ss1-ops/robotic-arm-5-digit-manipulator/gripper/aero-hand-open/hardware/README.md

**License:** [CC BY-NC-SA 4.0](https://creativecommons.org/licenses/by-nc-sa/4.0/) © 2025 TetherIA

[**Mechanical**](https://docs.tetheria.ai/docs/mechanical)

[**Assembly**](https://docs.tetheria.ai/docs/assembly)

[**Hardware Setup**](https://docs.tetheria.ai/docs/hardware_setup)

[**PCB**](https://docs.tetheria.ai/docs/pcb)

[**Firmware**](https://docs.tetheria.ai/docs/firmware)
