ss1-ops/robotic-arm-5-digit-manipulator/software/vision/ChArUCo Board.pdf

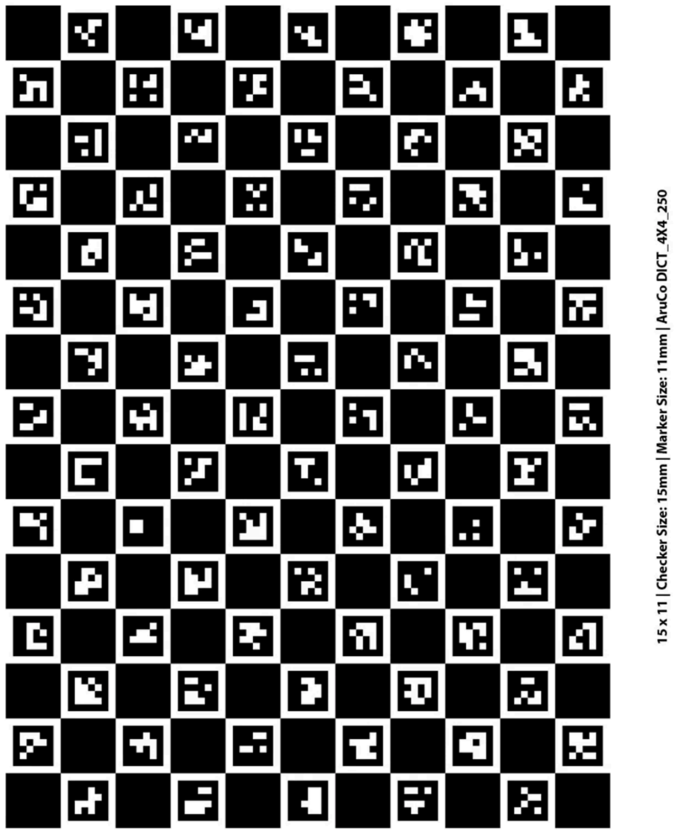
[picture p16: page 1]
