ss1-ops/robotic-arm-5-digit-manipulator/software/vision/charuco_7x5.pdf

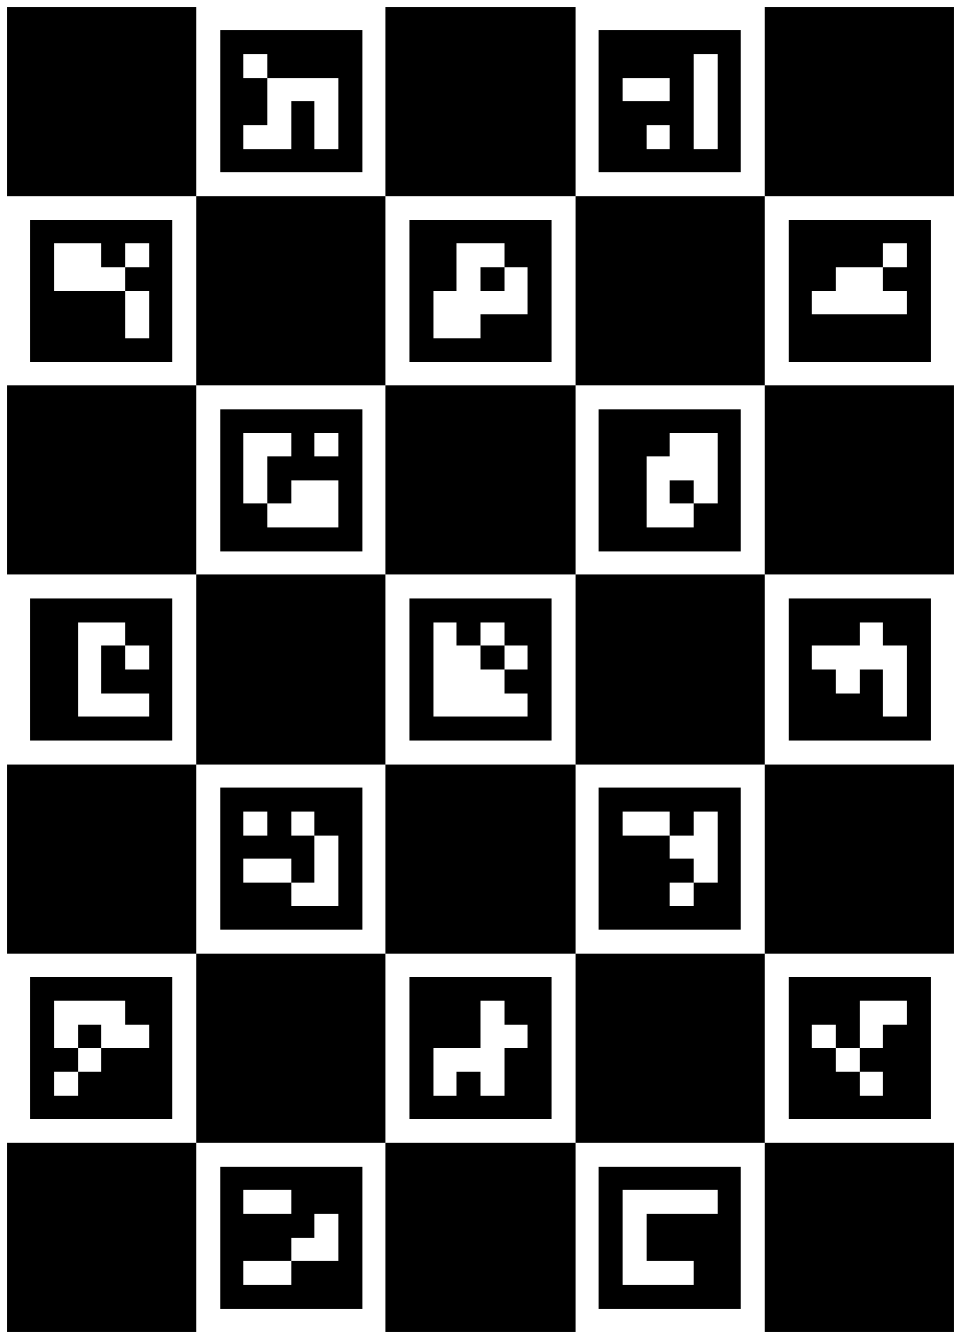
[picture p17: page 1]
