ss1-ops/robotic-arm-5-digit-manipulator/gripper/aero-hand-open/hardware/CAD/mount_adapters/assets/135degrees_adapter.png

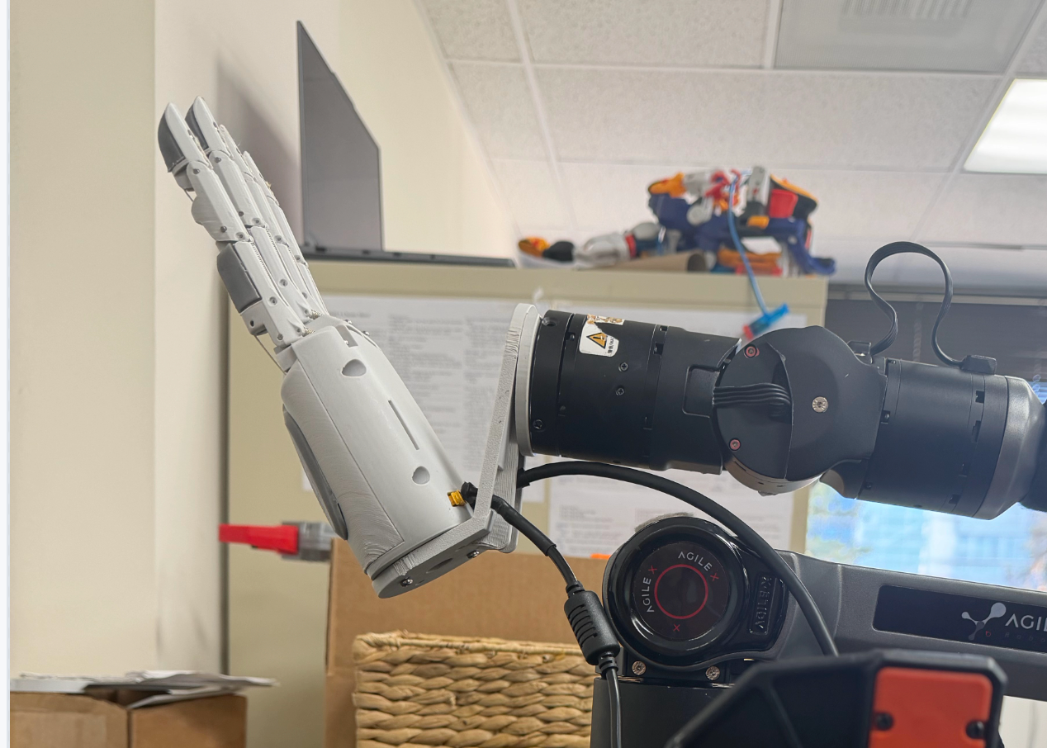
gripper/aero-hand-open/hardware/CAD/mount_adapters/assets/135degrees_adapter.png
