ss1-ops/robotic-arm-5-digit-manipulator/gripper/aero-hand-open/hardware/CAD/Molds/Proximal_Pad_Mold.stp

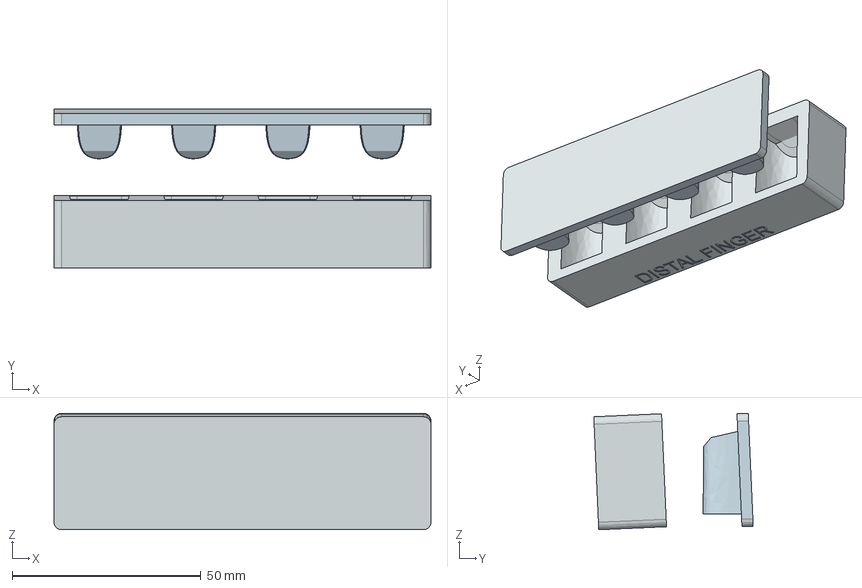
[picture p19: CAD file, 2026-04-10]
gripper/aero-hand-open/hardware/CAD/Molds/Proximal_Pad_Mold.stp
100.0 x 42.3 x 30.9 mm
