ss1-ops/robotic-arm-5-digit-manipulator/gripper/aero-hand-open/hardware/PCB/Components/100uF cap/100ufcap.stp

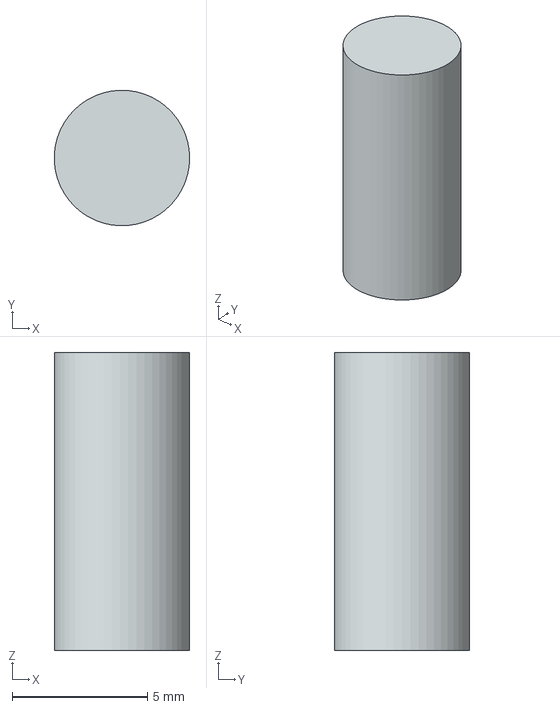
[picture p20: CAD file, 2026-04-10]
gripper/aero-hand-open/hardware/PCB/Components/100uF cap/100ufcap.stp
5.00 x 5.00 x 11.0 mm
