ss1-ops/robotic-arm-5-digit-manipulator/gripper/aero-hand-open/hardware/PCB/Components/ESP32s3/XIAO ESP32S3 3D.stp

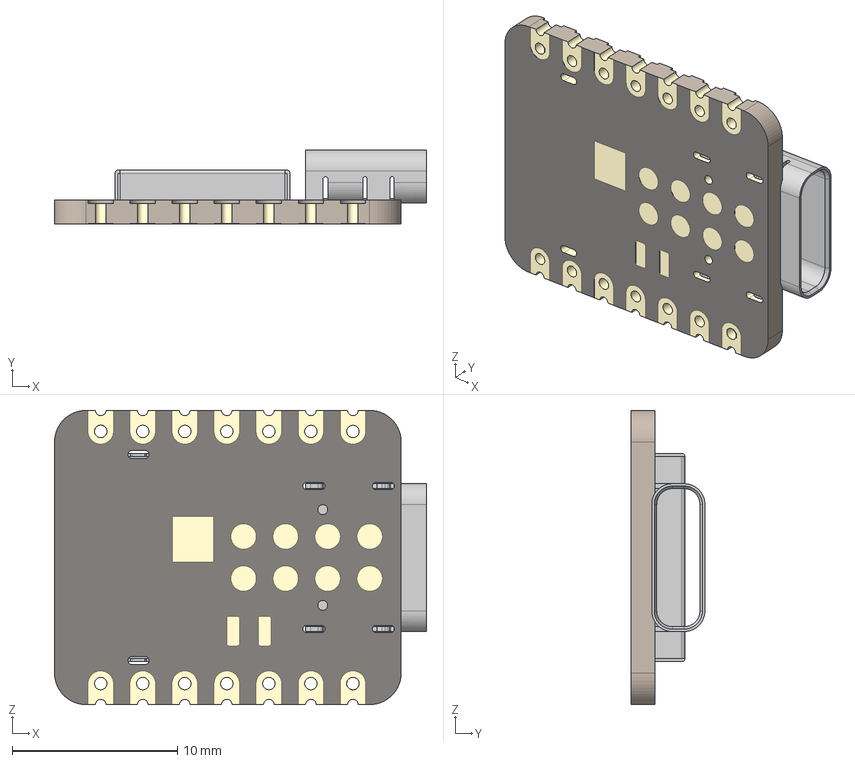
[picture p21: CAD file, 2026-04-10]
gripper/aero-hand-open/hardware/PCB/Components/ESP32s3/XIAO ESP32S3 3D.stp
22.5 x 4.46 x 17.8 mm
