ss1-ops/robotic-arm-5-digit-manipulator/gripper/aero-hand-open/hardware/PCB/Components/XT30PW-M/3D/XT30PW-M.stp

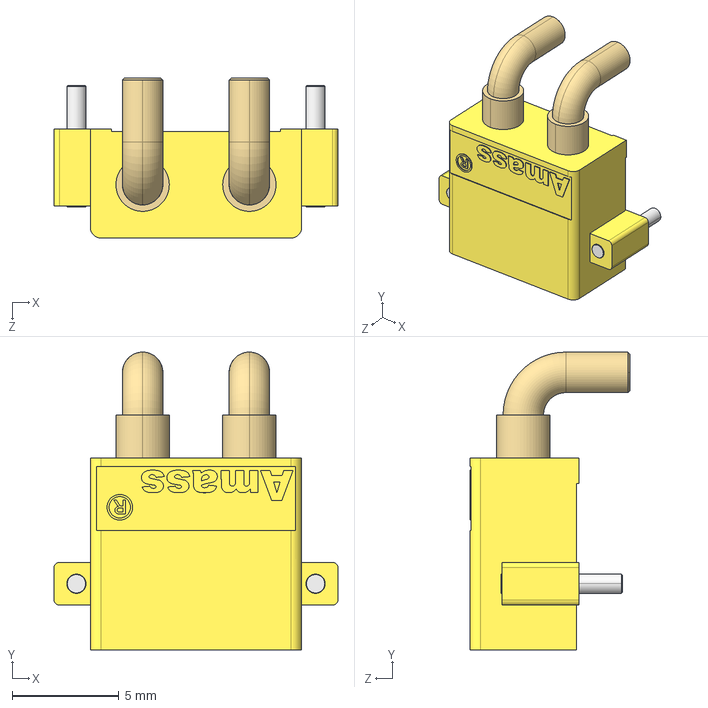
[picture p22: CAD file, 2026-04-10]
gripper/aero-hand-open/hardware/PCB/Components/XT30PW-M/3D/XT30PW-M.stp
13.3 x 13.9 x 7.50 mm
