ss1-ops/robotic-arm-5-digit-manipulator/gripper/aero-hand-open/hardware/CAD/Molds/Finger_Distal_Mold.stp

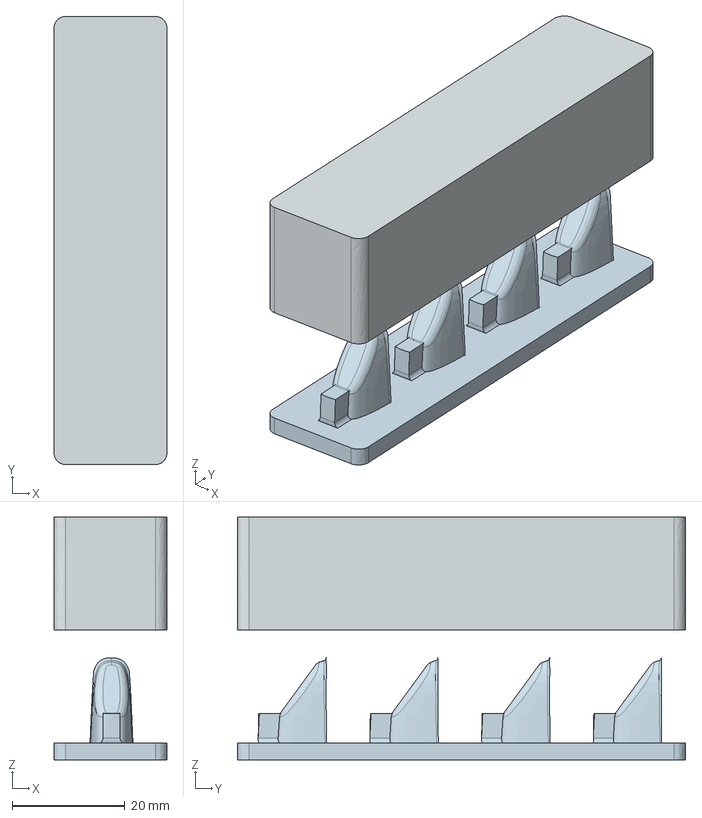
[picture p23: CAD file, 2026-04-10]
gripper/aero-hand-open/hardware/CAD/Molds/Finger_Distal_Mold.stp
20.0 x 79.4 x 43.0 mm
