ss1-ops/robotic-arm-5-digit-manipulator/gripper/aero-hand-open/hardware/CAD/Molds/Palm_Silicone_Mold_R.stp

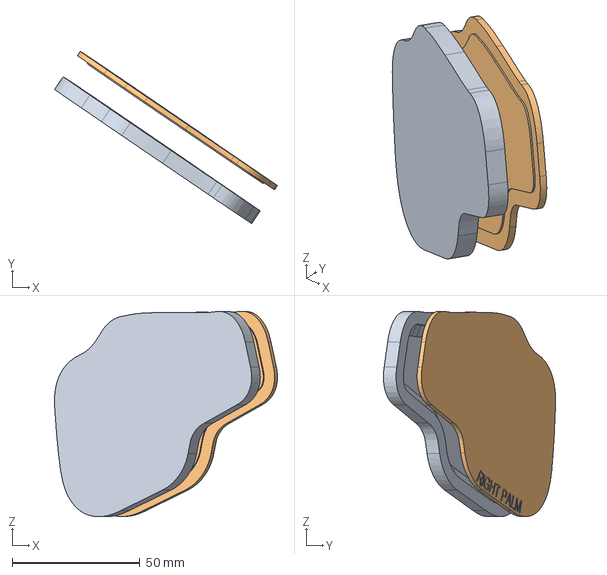
[picture p24: CAD file, 2026-04-10]
gripper/aero-hand-open/hardware/CAD/Molds/Palm_Silicone_Mold_R.stp
87.5 x 67.5 x 80.6 mm
