ss1-ops/robotic-arm-5-digit-manipulator/gripper/aero-hand-open/hardware/CAD/mount_adapters/G1_Open_Unitree_Converter.stp

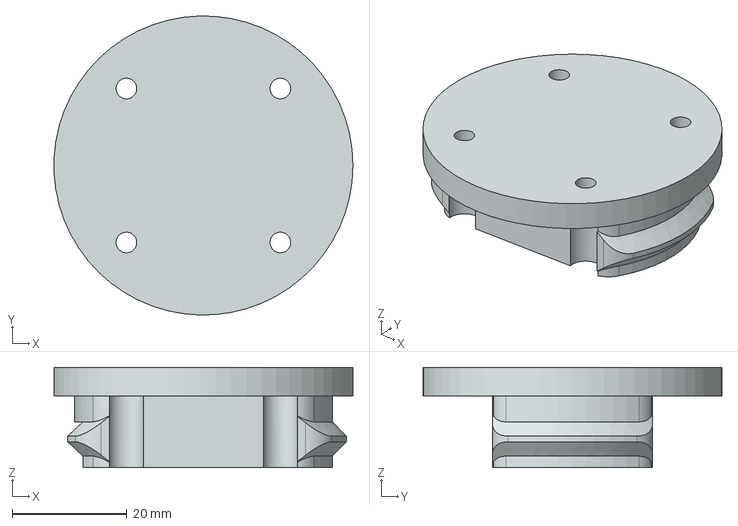
[picture p25: CAD file, 2026-04-10]
gripper/aero-hand-open/hardware/CAD/mount_adapters/G1_Open_Unitree_Converter.stp
52.2 x 52.2 x 17.5 mm
