ss1-ops/robotic-arm-5-digit-manipulator/gripper/aero-hand-open/hardware/CAD/Molds/Thumb_Distal_Pad_Mold.stp

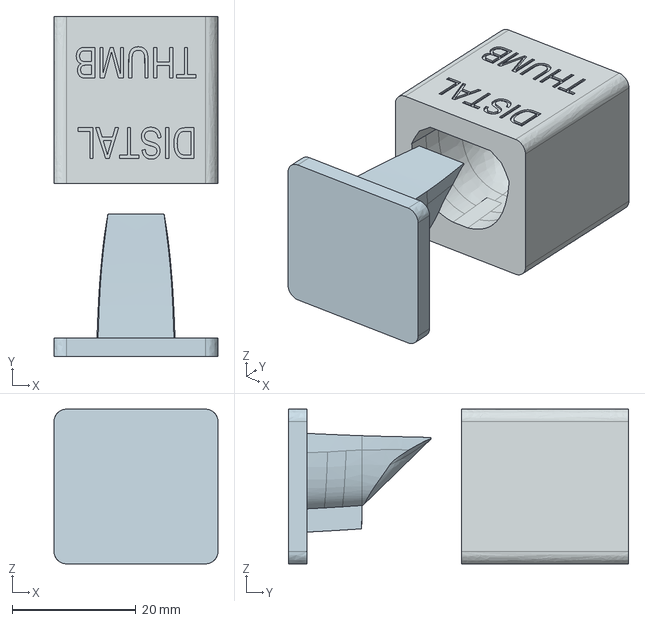
[picture p26: CAD file, 2026-04-10]
gripper/aero-hand-open/hardware/CAD/Molds/Thumb_Distal_Pad_Mold.stp
26.5 x 55.0 x 25.0 mm
