ss1-ops/robotic-arm-5-digit-manipulator/gripper/aero-hand-open/hardware/CAD/mount_adapters/piper_arm_adapter.stp

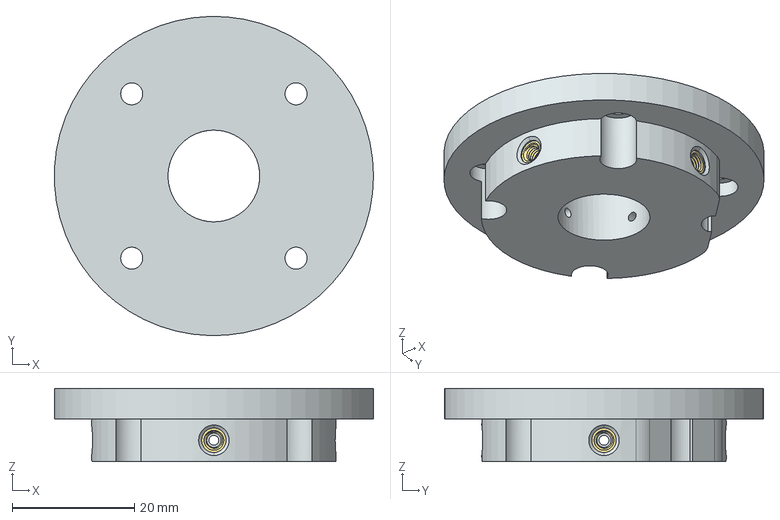
[picture p27: CAD file, 2026-04-10]
gripper/aero-hand-open/hardware/CAD/mount_adapters/piper_arm_adapter.stp
52.2 x 52.2 x 12.0 mm
