ss1-ops/robotic-arm-5-digit-manipulator/gripper/aero-hand-open/hardware/CAD/Molds/Palm_Silicone_Mold_L.stp

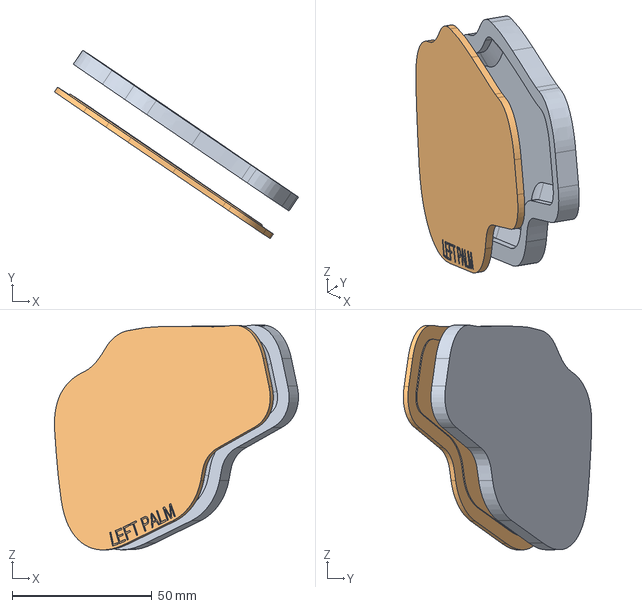
[picture p28: CAD file, 2026-04-10]
gripper/aero-hand-open/hardware/CAD/Molds/Palm_Silicone_Mold_L.stp
87.4 x 67.5 x 80.6 mm
