ss1-ops/robotic-arm-5-digit-manipulator/(list of files, cad)

Other CAD files:
gripper/aero-hand-open/hardware/CAD/mount_adapters/135degrees_adapter.stl
gripper/aero-hand-open/hardware/CAD/One_Click_Print_L.3mf
gripper/aero-hand-open/hardware/PCB/Aero_hand_open_left/Aero-Hand-Open-Left.step
gripper/aero-hand-open/hardware/PCB/Aero_hand_open_right/Aero-Hand-Open-Right.step
gripper/aero-hand-open/hardware/PCB/Components/3pin jst step file/S3P-VH-LF--SN---3DModel-STEP-56544.STEP
gripper/aero-hand-open/hardware/PCB/Components/7pinheadher 3dstep/7-Pin Header - Female - 2.54mm.step
gripper/aero-hand-open/hardware/PCB/Components/B3PS-VH_LF_SN/B3PS-VH_LF__SN_.step
gripper/aero-hand-open/hardware/PCB/Components/BAT54S (1)/BAT54S.step
gripper/aero-hand-open/hardware/PCB/Components/MMBT2907A/MMBT2907A.STEP
gripper/aero-hand-open/hardware/PCB/Components/Molex 220305025/22-03-5035.step
gripper/aero-hand-open/hardware/PCB/Components/SN74LVC1G125DBVR/SN74LVC1G125DBVR.step
gripper/aero-hand-open/hardware/PCB/Components/SN74LVC1G126DBVR/SN74LVC1G126DBVR.step
gripper/aero-hand-open/hardware/PCB/Components/terminal block 3d/KF128-5.08-2P.STEP
gripper/aero-hand-open/hardware/PCB/Components/zener diode/BZT52B5V1S.step
gripper/aero-hand-open/ros2/src/aero_hand_open_description/meshes/right_pinky_tip_link.STL
hardware/cad/T4M1E.stl
hardware/enclosure/17HS15-1684S-PG5 - Waist T5 Pulley.stl
hardware/enclosure/Stepper Plug/Female Back.stl
reference/bcn3d-moveo/part-2/BCN3D MOVEO - A fully OpenSource 3D printed Robot Arm - 1693444 - part 2 of 2/files/4M1 - coupler mod for geared wrist roll.stl
software/pi/moveo_ws/src/moveo_description/meshes/Gripper_Servo_Gear_col.stl
software/vision/4M2 - Vision Mount and EE Adapter.step
gripper/aero-hand-open/hardware/CAD/mount_adapters/threaded_mount_adapter.stl
gripper/aero-hand-open/hardware/CAD/One_Click_Print_R.3mf
gripper/aero-hand-open/hardware/PCB/Components/ESP32s3/XIAO-ESP32S3 v2.step
gripper/aero-hand-open/ros2/src/aero_hand_open_description/meshes/right_pinky_middle_link.STL
hardware/enclosure/Robotic Arm Platform - Rubber Inserts.stl
hardware/enclosure/Stepper Plug/Female Front.stl
reference/bcn3d-moveo/part-2/BCN3D MOVEO - A fully OpenSource 3D printed Robot Arm - 1693444 - part 2 of 2/files/3M2 with pg5 stepper.stl
software/pi/moveo_ws/src/moveo_description/meshes/Pivot_Arm_Gripper_Idol.stl
software/vision/New Vision Mount.step
gripper/aero-hand-open/ros2/src/aero_hand_open_description/meshes/left_thumb_mcp_link.STL
hardware/cad/T3M1C.stl
hardware/enclosure/Rubber Feet.stl
hardware/enclosure/Stepper Plug/Male Front.stl
reference/bcn3d-moveo/part-2/BCN3D MOVEO - A fully OpenSource 3D printed Robot Arm - 1693444 - part 2 of 2/files/3M2C with pg5 stepper.stl
software/pi/moveo_ws/src/moveo_description/meshes/base_link.stl
software/vision/Stereo Camera Mount.stl
gripper/aero-hand-open/ros2/src/aero_hand_open_description/meshes/left_pinky_proximal_link.STL
hardware/cad/T2M1BI.stl
hardware/enclosure/Robotic Arm Platform - Driver Door.stl
hardware/enclosure/Stepper Plug/Male Back.stl
reference/bcn3d-moveo/part-2/BCN3D MOVEO - A fully OpenSource 3D printed Robot Arm - 1693444 - part 2 of 2/files/Cilinder.STL
software/pi/moveo_ws/src/moveo_description/meshes/Link_5.stl
gripper/aero-hand-open/ros2/src/aero_hand_open_description/meshes/left_thumb_proximal_link.STL
hardware/enclosure/Robotic Arm Platform - Driver Rail.stl
reference/bcn3d-moveo/part-2/BCN3D MOVEO - A fully OpenSource 3D printed Robot Arm - 1693444 - part 2 of 2/files/Fan_Module.STL
software/pi/moveo_ws/src/moveo_description/meshes/Link_1_col.stl
gripper/aero-hand-open/hardware/CAD/Molds/One_Click_Print_Molds_R+L.3mf
gripper/aero-hand-open/ros2/src/aero_hand_open_description/meshes/right_index_middle_link.STL
hardware/cad/Robotic Arm Parts Print.3mf
hardware/enclosure/Robotic Arm Platform - Top.3mf
reference/bcn3d-moveo/part-2/BCN3D MOVEO - A fully OpenSource 3D printed Robot Arm - 1693444 - part 2 of 2/files/Bottom_Plate.STL
software/pi/moveo_ws/src/moveo_description/meshes/Pivot_Arm_Gripper_Idol_col.stl
gripper/aero-hand-open/ros2/src/aero_hand_open_description/meshes/right_middle_tip_link.STL
hardware/cad/T2M1BD.stl
hardware/enclosure/Robotic Arm Platform - Bottom.stl
reference/bcn3d-moveo/part-2/BCN3D MOVEO - A fully OpenSource 3D printed Robot Arm - 1693444 - part 2 of 2/files/3M2C.STL
software/pi/moveo_ws/src/moveo_description/meshes/Gripper_Idol_Gear.stl
gripper/aero-hand-open/ros2/src/aero_hand_open_description/meshes/right_index_tip_link.STL
hardware/cad/10 tooth T5 Pulley 15mm width.step
hardware/enclosure/Robotic Arm Platform - Bottom Plate.stl
reference/bcn3d-moveo/part-2/BCN3D MOVEO - A fully OpenSource 3D printed Robot Arm - 1693444 - part 2 of 2/files/1M3.STL
software/pi/moveo_ws/src/moveo_description/meshes/Link_2.stl
gripper/aero-hand-open/ros2/src/aero_hand_open_description/meshes/right_pinky_proximal_link.STL
reference/bcn3d-moveo/part-2/BCN3D MOVEO - A fully OpenSource 3D printed Robot Arm - 1693444 - part 2 of 2/files/Pivot_Arm.STL
software/pi/moveo_ws/src/moveo_description/meshes/Gripper_Servo_Gear.stl
gripper/aero-hand-open/ros2/src/aero_hand_open_description/meshes/right_middle_middle_link.STL
reference/bcn3d-moveo/part-2/BCN3D MOVEO - A fully OpenSource 3D printed Robot Arm - 1693444 - part 2 of 2/files/4M2C.STL
software/pi/moveo_ws/src/moveo_description/meshes/Link_3_col.stl
gripper/aero-hand-open/ros2/src/aero_hand_open_description/meshes/right_ring_distal_link.STL
reference/bcn3d-moveo/part-2/BCN3D MOVEO - A fully OpenSource 3D printed Robot Arm - 1693444 - part 2 of 2/files/3M1.STL
software/pi/moveo_ws/src/moveo_description/meshes/Tip_Gripper_Servo.stl
gripper/aero-hand-open/ros2/src/aero_hand_open_description/meshes/left_index_tip_link.STL
reference/bcn3d-moveo/part-2/BCN3D MOVEO - A fully OpenSource 3D printed Robot Arm - 1693444 - part 2 of 2/files/Tapa_2M1.STL
software/pi/moveo_ws/src/moveo_description/meshes/Pivot_Arm_Gripper_Servo_col.stl
gripper/aero-hand-open/ros2/src/aero_hand_open_description/meshes/right_thumb_distal_link.STL
reference/bcn3d-moveo/part-2/BCN3D MOVEO - A fully OpenSource 3D printed Robot Arm - 1693444 - part 2 of 2/files/Idol_Gear.STL
software/pi/moveo_ws/src/moveo_description/meshes/Tip_Gripper_Idol_col.stl
gripper/aero-hand-open/ros2/src/aero_hand_open_description/meshes/left_ring_proximal_link.STL
reference/bcn3d-moveo/part-2/BCN3D MOVEO - A fully OpenSource 3D printed Robot Arm - 1693444 - part 2 of 2/files/Gripper_Right.STL
software/pi/moveo_ws/src/moveo_description/meshes/Link_3.stl
gripper/aero-hand-open/ros2/src/aero_hand_open_description/meshes/left_ring_distal_link.STL
reference/bcn3d-moveo/part-2/BCN3D MOVEO - A fully OpenSource 3D printed Robot Arm - 1693444 - part 2 of 2/files/Tapa_TBB.STL
software/pi/moveo_ws/src/moveo_description/meshes/Link_1.stl
gripper/aero-hand-open/ros2/src/aero_hand_open_description/meshes/left_thumb_distal_link.STL
reference/bcn3d-moveo/part-2/BCN3D MOVEO - A fully OpenSource 3D printed Robot Arm - 1693444 - part 2 of 2/files/Top_Plate.STL
software/pi/moveo_ws/src/moveo_description/meshes/Pivot_Arm_Gripper_Servo.stl
gripper/aero-hand-open/ros2/src/aero_hand_open_description/meshes/right_index_distal_link.STL
reference/bcn3d-moveo/part-2/BCN3D MOVEO - A fully OpenSource 3D printed Robot Arm - 1693444 - part 2 of 2/files/2M2M.STL
software/pi/moveo_ws/src/moveo_description/meshes/Tip_Gripper_Servo_col.stl
gripper/aero-hand-open/ros2/src/aero_hand_open_description/meshes/right_ring_middle_link.STL
reference/bcn3d-moveo/part-2/BCN3D MOVEO - A fully OpenSource 3D printed Robot Arm - 1693444 - part 2 of 2/files/Suport_Drivers.STL
software/pi/moveo_ws/src/moveo_description/meshes/base_link_col.stl
gripper/aero-hand-open/ros2/src/aero_hand_open_description/meshes/right_t_link.STL
reference/bcn3d-moveo/part-2/BCN3D MOVEO - A fully OpenSource 3D printed Robot Arm - 1693444 - part 2 of 2/files/2M2H.STL
software/pi/moveo_ws/src/moveo_description/meshes/Tip_Gripper_Idol.stl
gripper/aero-hand-open/ros2/src/aero_hand_open_description/meshes/right_thumb_proximal_link.STL
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
