ss1-ops/robotic-arm-5-digit-manipulator/reference/bcn3d-moveo/part-1/BCN3D MOVEO - A fully OpenSource 3D printed Robot Arm - 1693444 - part 1 of 2/README.txt

BCN3D MOVEO - A fully OpenSource 3D printed Robot Arm by BCN3D on Thingiverse: https://www.thingiverse.com/thing:1693444

Summary:
BCN3D Technologies (www.bcn3dtechnologies.com) keeps taking important steps in order to achieve his goal of bringing the digital manufacturing technology to everyone. In this occasion we are presenting the BCN3D Moveo, a robotic arm design from scratch and developed by our engineers in collaboration with the Departament d’Ensenyament from the Generalitat de Catalunya. Its structure is fully printed using additive manufacturing technologies and its electronics are controlled by the software Arduino. The BCN3D Moveo has 5 axis.Moveo, fully functional nowadays, has been born, as all the BCN3D Technologies products, with an open and educational wish.https://www.youtube.com/watch?v=XSY0kieEL8AMeet the new BCN3D Printers, the R19 series: https://www.youtube.com/watch?v=q7UxQWz5Nm8As we have done with all our developed products, the BCN3D Moveo files will be available for everyone. Thanks to the platform Github, a website where users around the world share their designs, anyone will be able to obtain all the necessary information in order to assemble his own BCN3D Moveo at home.Nevertheless, BCN3D will fee all the Moveo know how on our Github account, as we have been doing with all the BCN3D Technologies products. Thus, the users will be able to find the bill of material (BOM), where all the needed components for the assembling of the arm come detailed, as the CAD designs, so anyone will be able to modify the BCN3D Moveo design as they wish.Furthermore, the Github users will find the STL files for the structure printing and the assembling, fine tuning and firmware upload manuals, which will be available both in English and Spanish.Download the BCN3D Moveo CAD files, the STL files, the assembly and user manual and the Bill of Materials on our Github: https://github.com/BCN3DRead the full article: https://www.bcn3dtechnologies.com/en/bcn3d-moveo-the-future-of-learning/Thanks to this project motivated by the Departament d’Ensenyament and developed by BCN3D Technologies everyone will be able to fabricate their own robotic arm at home, no highly technical knowledge needed. Therefore, we encourage you to fabricate the BCN3D Moveo and share the results on the social networks using the hashtag #BCN3DMoveo.You can also follow us through our social media channels in order to get more information about us: Instagram: https://www.instagram.com/bcn3dtech/Facebook: https://www.facebook.com/bcn3dtechnologies/Twitter: https://twitter.com/bcn3dtech
