ss1-ops/robotic-arm-5-digit-manipulator/gripper/aero-hand-open/hardware/CAD/mount_adapters/Adapter_Assembly_Instructions.pdf

Adapter Assembly Instructions

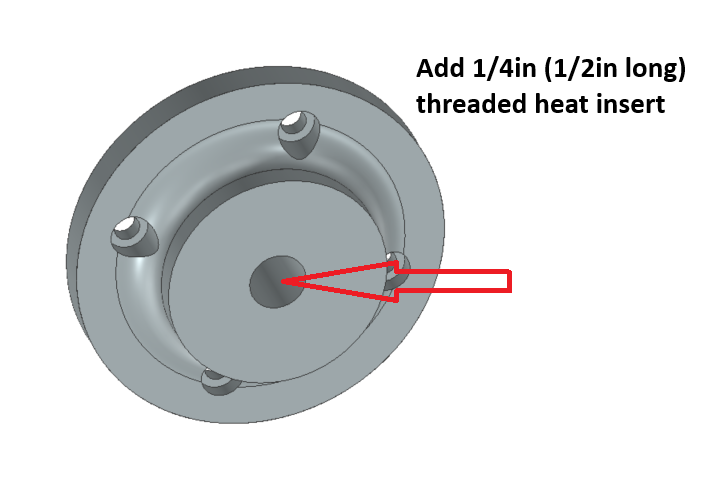
[picture p71: figure]

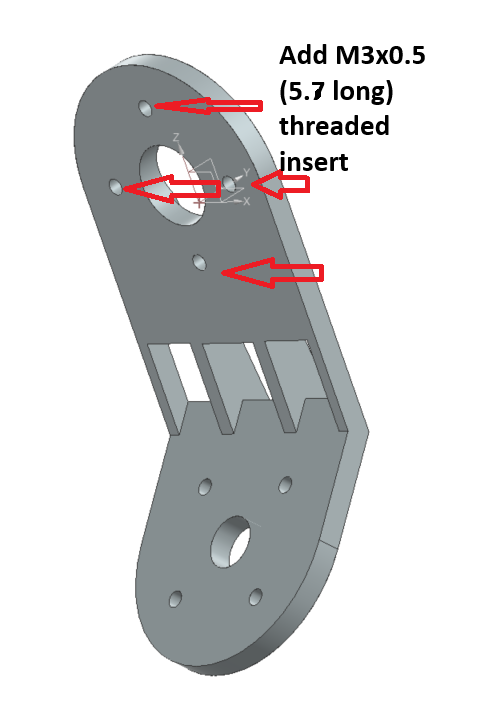
[picture p72: figure]
