ss1-ops/robotic-arm-5-digit-manipulator/reference/bcn3d-moveo/part-1/BCN3D MOVEO - A fully OpenSource 3D printed Robot Arm - 1693444 - part 1 of 2/images/1f444959a8cd11b5827f4bccaf91a1ba.png

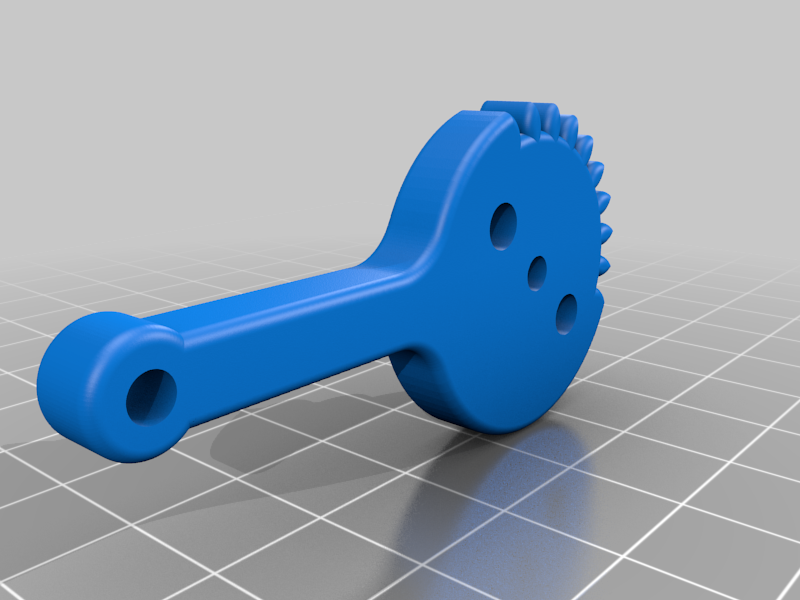
reference/bcn3d-moveo/part-1/BCN3D MOVEO - A fully OpenSource 3D printed Robot Arm - 1693444 - part 1 of 2/images/1f444959a8cd11b5827f4bccaf91a1ba.png
