ss1-ops/robotic-arm-5-digit-manipulator/reference/bcn3d-moveo/part-1/BCN3D MOVEO - A fully OpenSource 3D printed Robot Arm - 1693444 - part 1 of 2/images/7e8b69b75b3eef5f8a8cad47141f963c.png

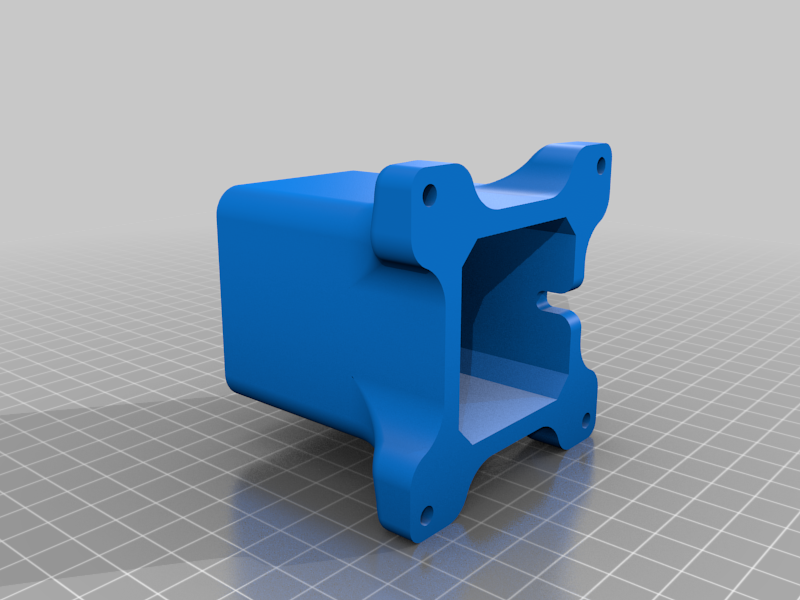
reference/bcn3d-moveo/part-1/BCN3D MOVEO - A fully OpenSource 3D printed Robot Arm - 1693444 - part 1 of 2/images/7e8b69b75b3eef5f8a8cad47141f963c.png
