ss1-ops/robotic-arm-5-digit-manipulator/reference/bcn3d-moveo/part-1/BCN3D MOVEO - A fully OpenSource 3D printed Robot Arm - 1693444 - part 1 of 2/images/07780c7e88622bead12cc4ba31680f6a.png

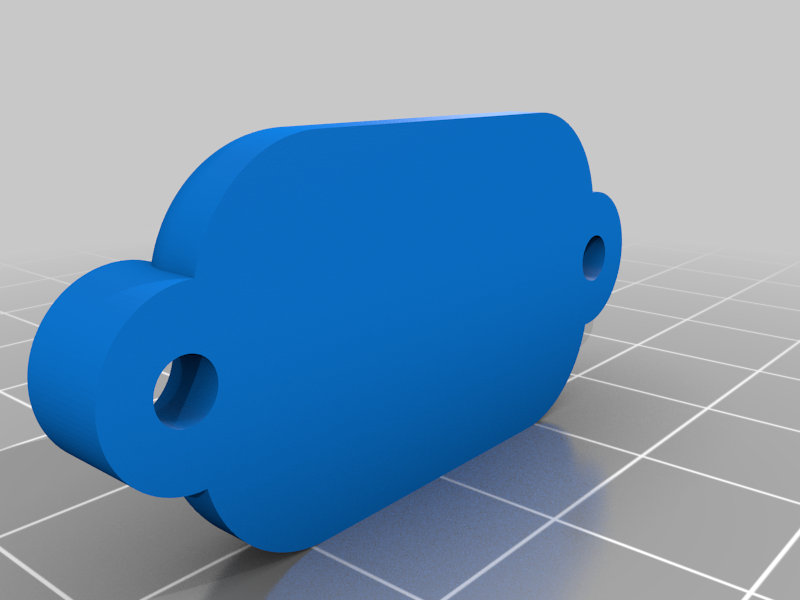
reference/bcn3d-moveo/part-1/BCN3D MOVEO - A fully OpenSource 3D printed Robot Arm - 1693444 - part 1 of 2/images/07780c7e88622bead12cc4ba31680f6a.png
