ss1-ops/robotic-arm-5-digit-manipulator/reference/bcn3d-moveo/part-1/BCN3D MOVEO - A fully OpenSource 3D printed Robot Arm - 1693444 - part 1 of 2/images/5533359e4e36c1fb36ee88d21f29aa08.png

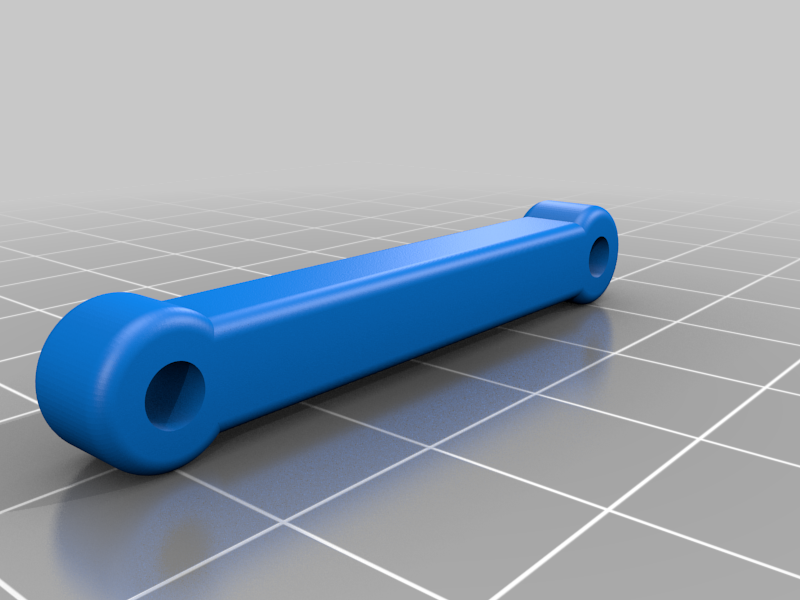
reference/bcn3d-moveo/part-1/BCN3D MOVEO - A fully OpenSource 3D printed Robot Arm - 1693444 - part 1 of 2/images/5533359e4e36c1fb36ee88d21f29aa08.png
