ss1-ops/robotic-arm-5-digit-manipulator/reference/bcn3d-moveo/part-2/BCN3D MOVEO - A fully OpenSource 3D printed Robot Arm - 1693444 - part 2 of 2/images/2f2f13d927295bb02d2b3b2d8390b2e0.png

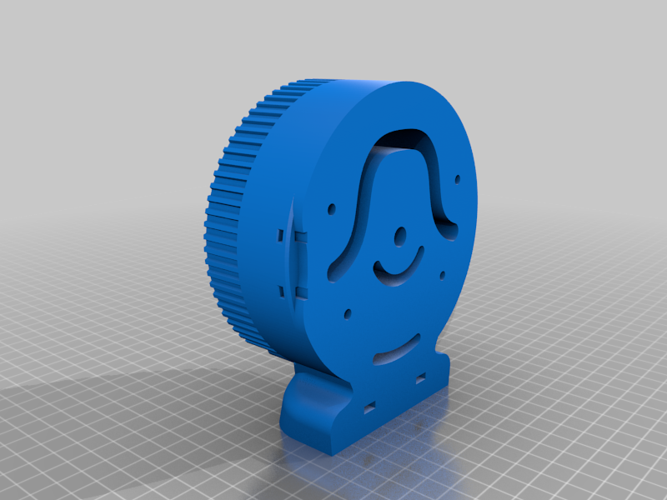
reference/bcn3d-moveo/part-2/BCN3D MOVEO - A fully OpenSource 3D printed Robot Arm - 1693444 - part 2 of 2/images/2f2f13d927295bb02d2b3b2d8390b2e0.png
