ss1-ops/robotic-arm-5-digit-manipulator/reference/bcn3d-moveo/part-2/BCN3D MOVEO - A fully OpenSource 3D printed Robot Arm - 1693444 - part 2 of 2/images/2fe13c6e6a7c613485f387ccfe14421d.png

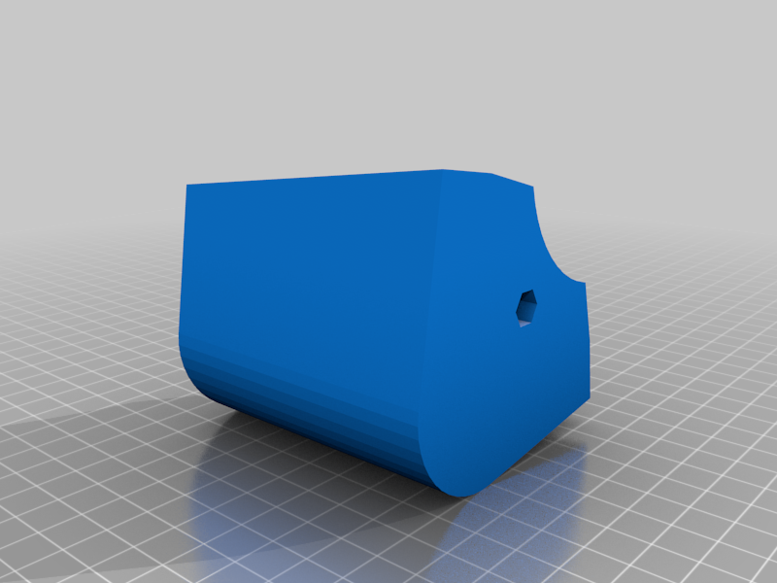
reference/bcn3d-moveo/part-2/BCN3D MOVEO - A fully OpenSource 3D printed Robot Arm - 1693444 - part 2 of 2/images/2fe13c6e6a7c613485f387ccfe14421d.png
