ss1-ops/robotic-arm-5-digit-manipulator/reference/bcn3d-moveo/part-2/BCN3D MOVEO - A fully OpenSource 3D printed Robot Arm - 1693444 - part 2 of 2/images/3abef437e9d2ab7c42597c3ab17b7399.png

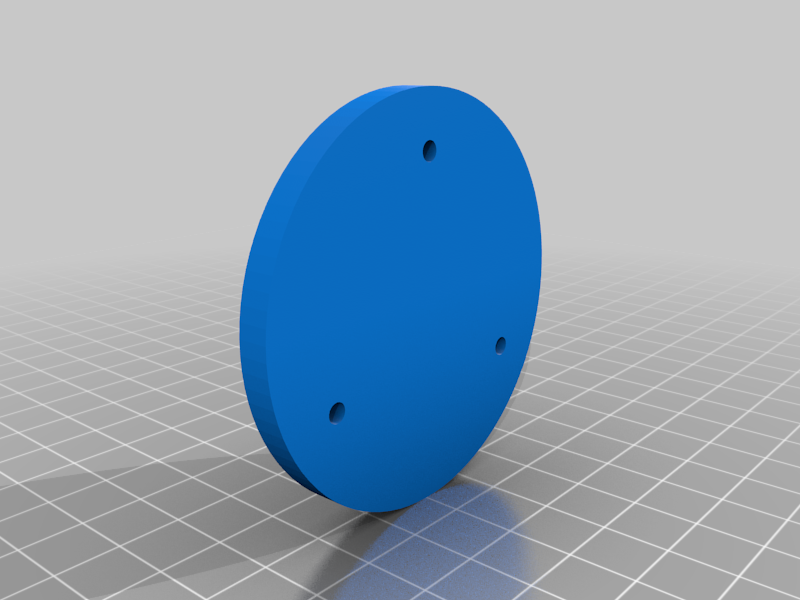
reference/bcn3d-moveo/part-2/BCN3D MOVEO - A fully OpenSource 3D printed Robot Arm - 1693444 - part 2 of 2/images/3abef437e9d2ab7c42597c3ab17b7399.png
