ss1-ops/robotic-arm-5-digit-manipulator/reference/bcn3d-moveo/part-2/BCN3D MOVEO - A fully OpenSource 3D printed Robot Arm - 1693444 - part 2 of 2/images/31d16f2b2b0395c10734665f50baa207.png

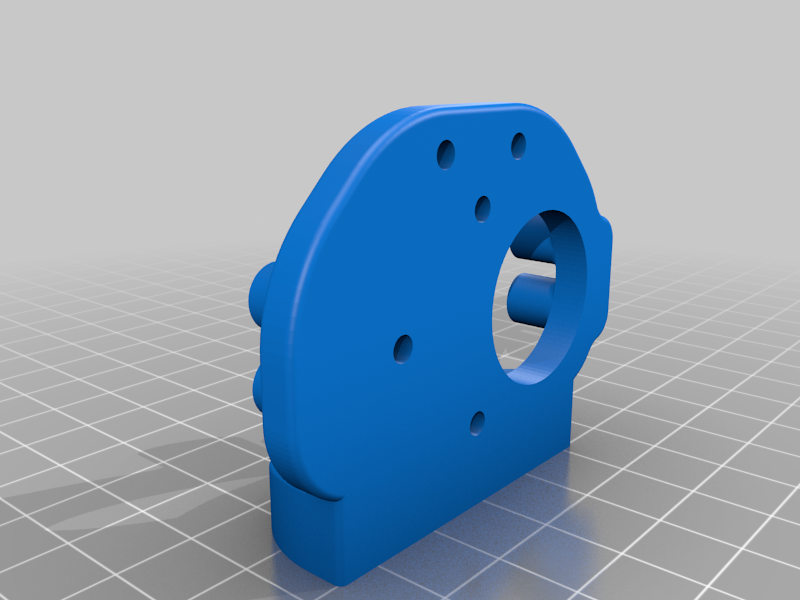
reference/bcn3d-moveo/part-2/BCN3D MOVEO - A fully OpenSource 3D printed Robot Arm - 1693444 - part 2 of 2/images/31d16f2b2b0395c10734665f50baa207.png
