ss1-ops/robotic-arm-5-digit-manipulator/reference/bcn3d-moveo/part-2/BCN3D MOVEO - A fully OpenSource 3D printed Robot Arm - 1693444 - part 2 of 2/images/75ccd95eae26bca7d29494922767a893.png

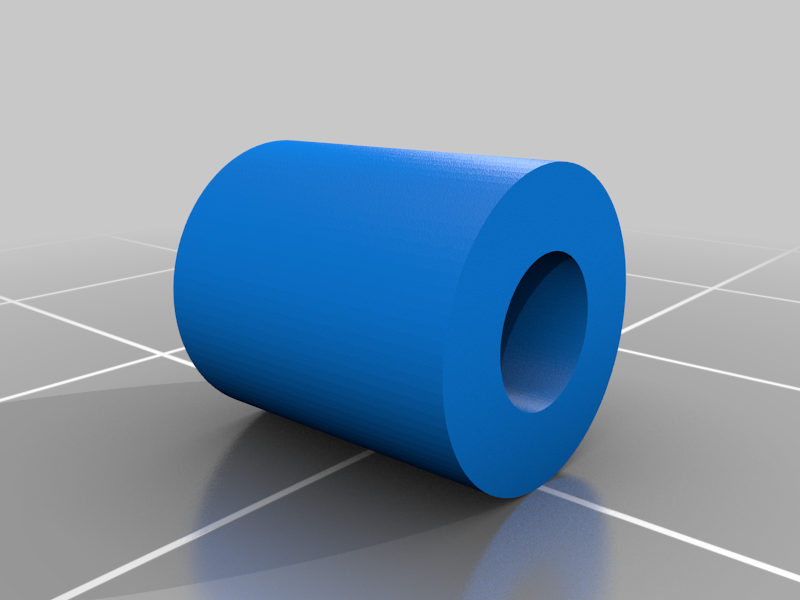
reference/bcn3d-moveo/part-2/BCN3D MOVEO - A fully OpenSource 3D printed Robot Arm - 1693444 - part 2 of 2/images/75ccd95eae26bca7d29494922767a893.png
