ss1-ops/robotic-arm-5-digit-manipulator/software/vision/calibration/captures_remount/left/pair_024.png

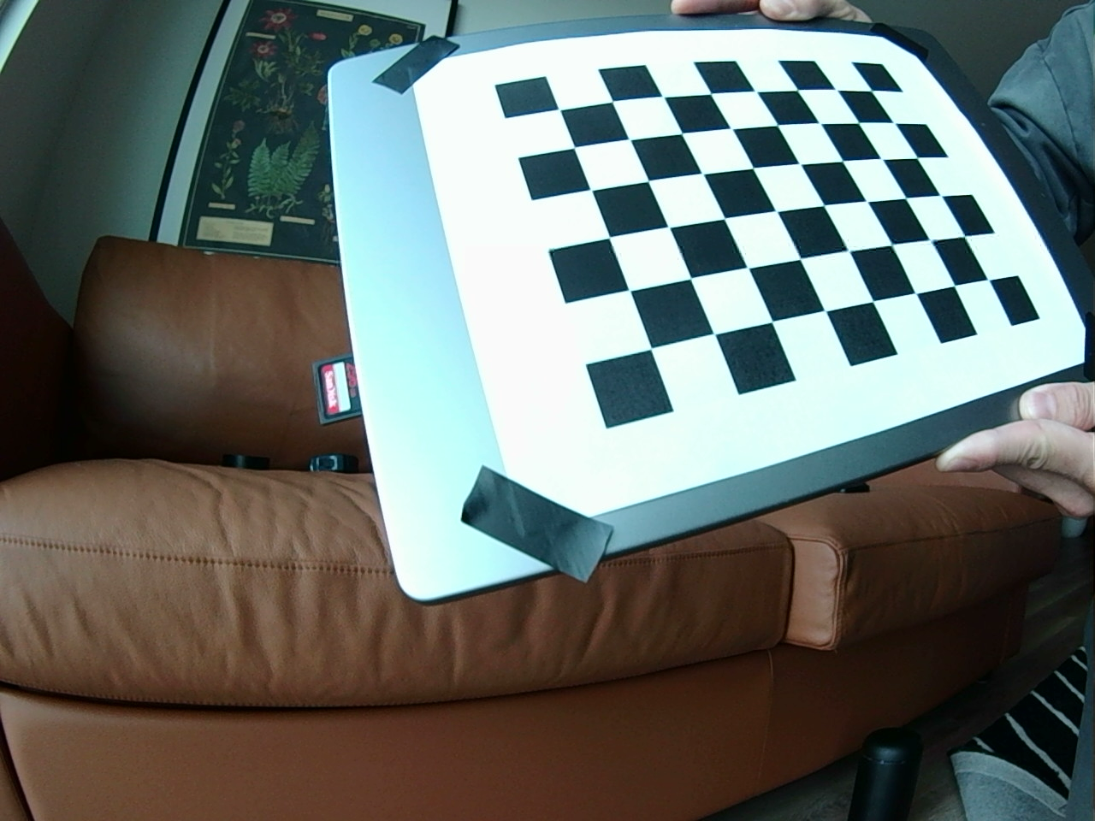
software/vision/calibration/captures_remount/left/pair_024.png
