ss1-ops/robotic-arm-5-digit-manipulator/software/vision/calibration/captures_remount/right/pair_005.png

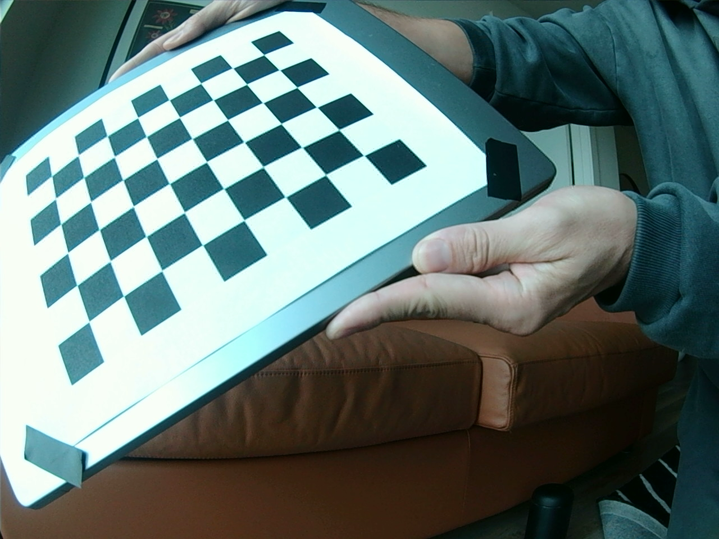
software/vision/calibration/captures_remount/right/pair_005.png
