ss1-ops/robotic-arm-5-digit-manipulator/software/vision/calibration/captures_remount/right/pair_027.png

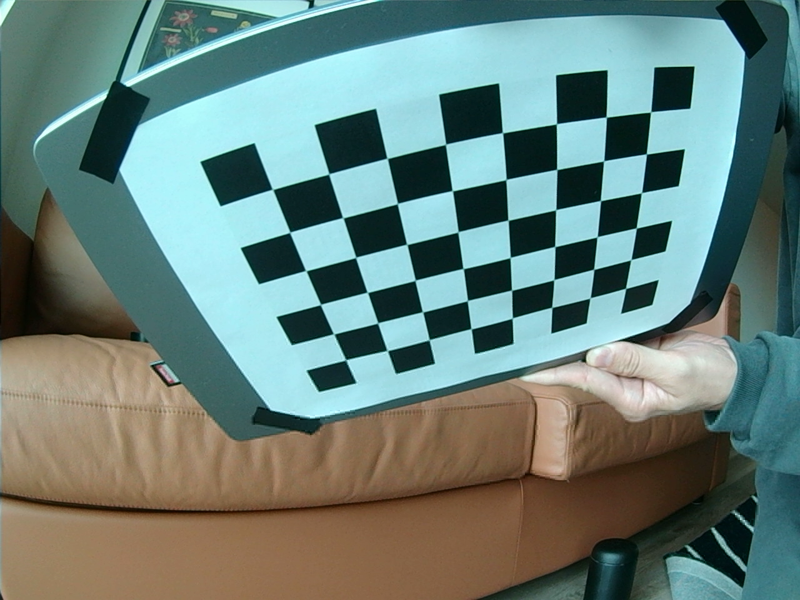
software/vision/calibration/captures_remount/right/pair_027.png
