ss1-ops/robotic-arm-5-digit-manipulator/software/vision/calibration/charuco_7x5.png

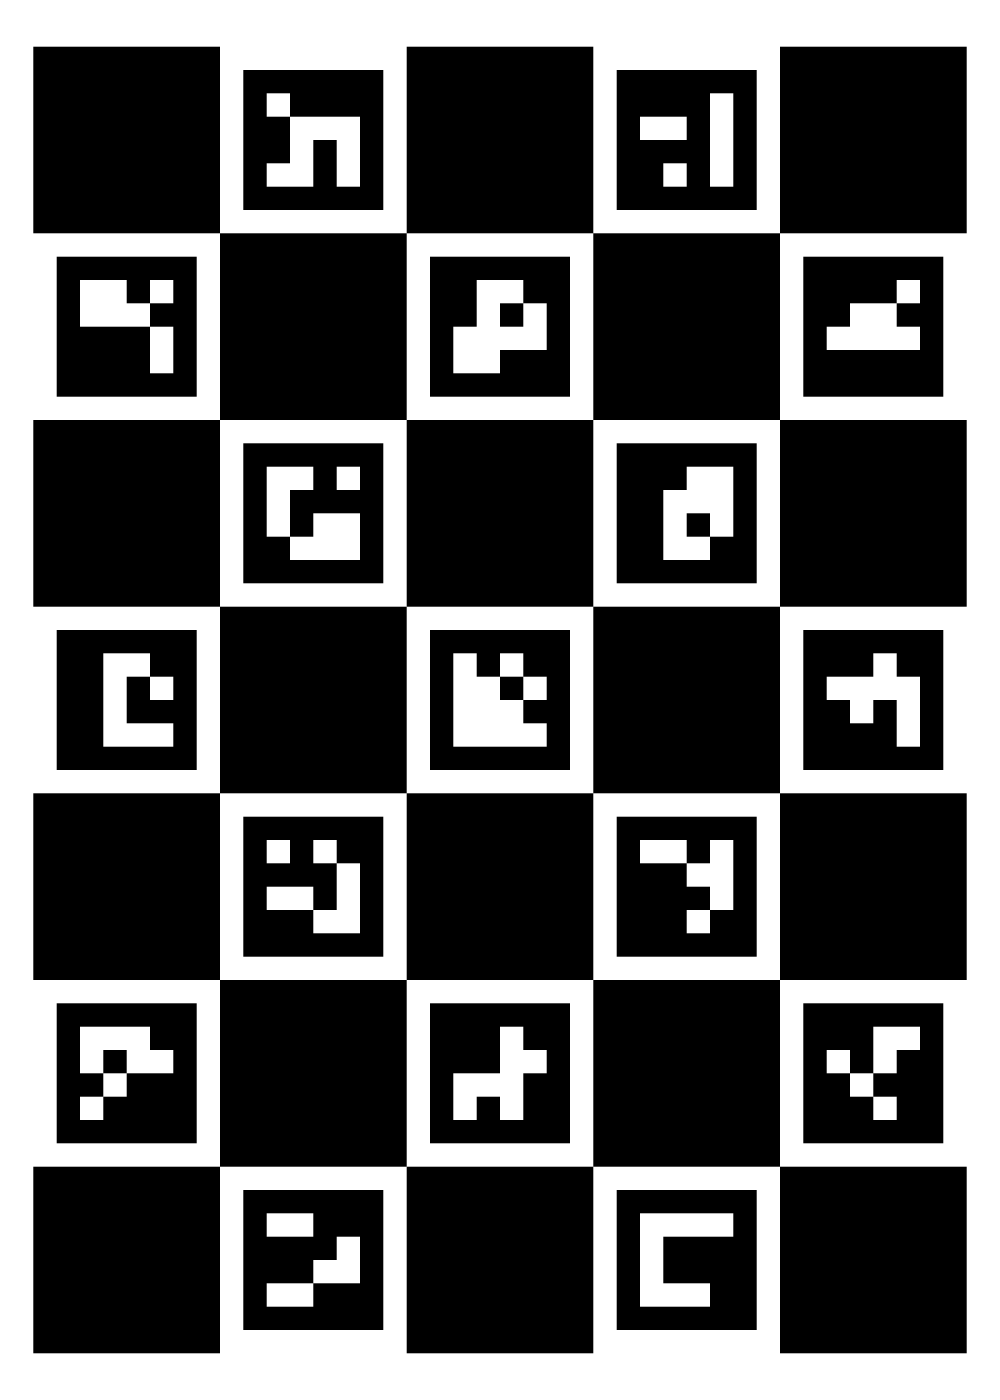
software/vision/calibration/charuco_7x5.png
