ss1-ops/robotic-arm-5-digit-manipulator/gripper/aero-hand-open/hardware/PCB/Aero_hand_open_left/Aero-Hand-Open-Left.kicad_pcb

## KiCad design gripper/aero-hand-open/hardware/PCB/Aero_hand_open_left/Aero-Hand-Open-Left.kicad_pcb (2026-04-10)

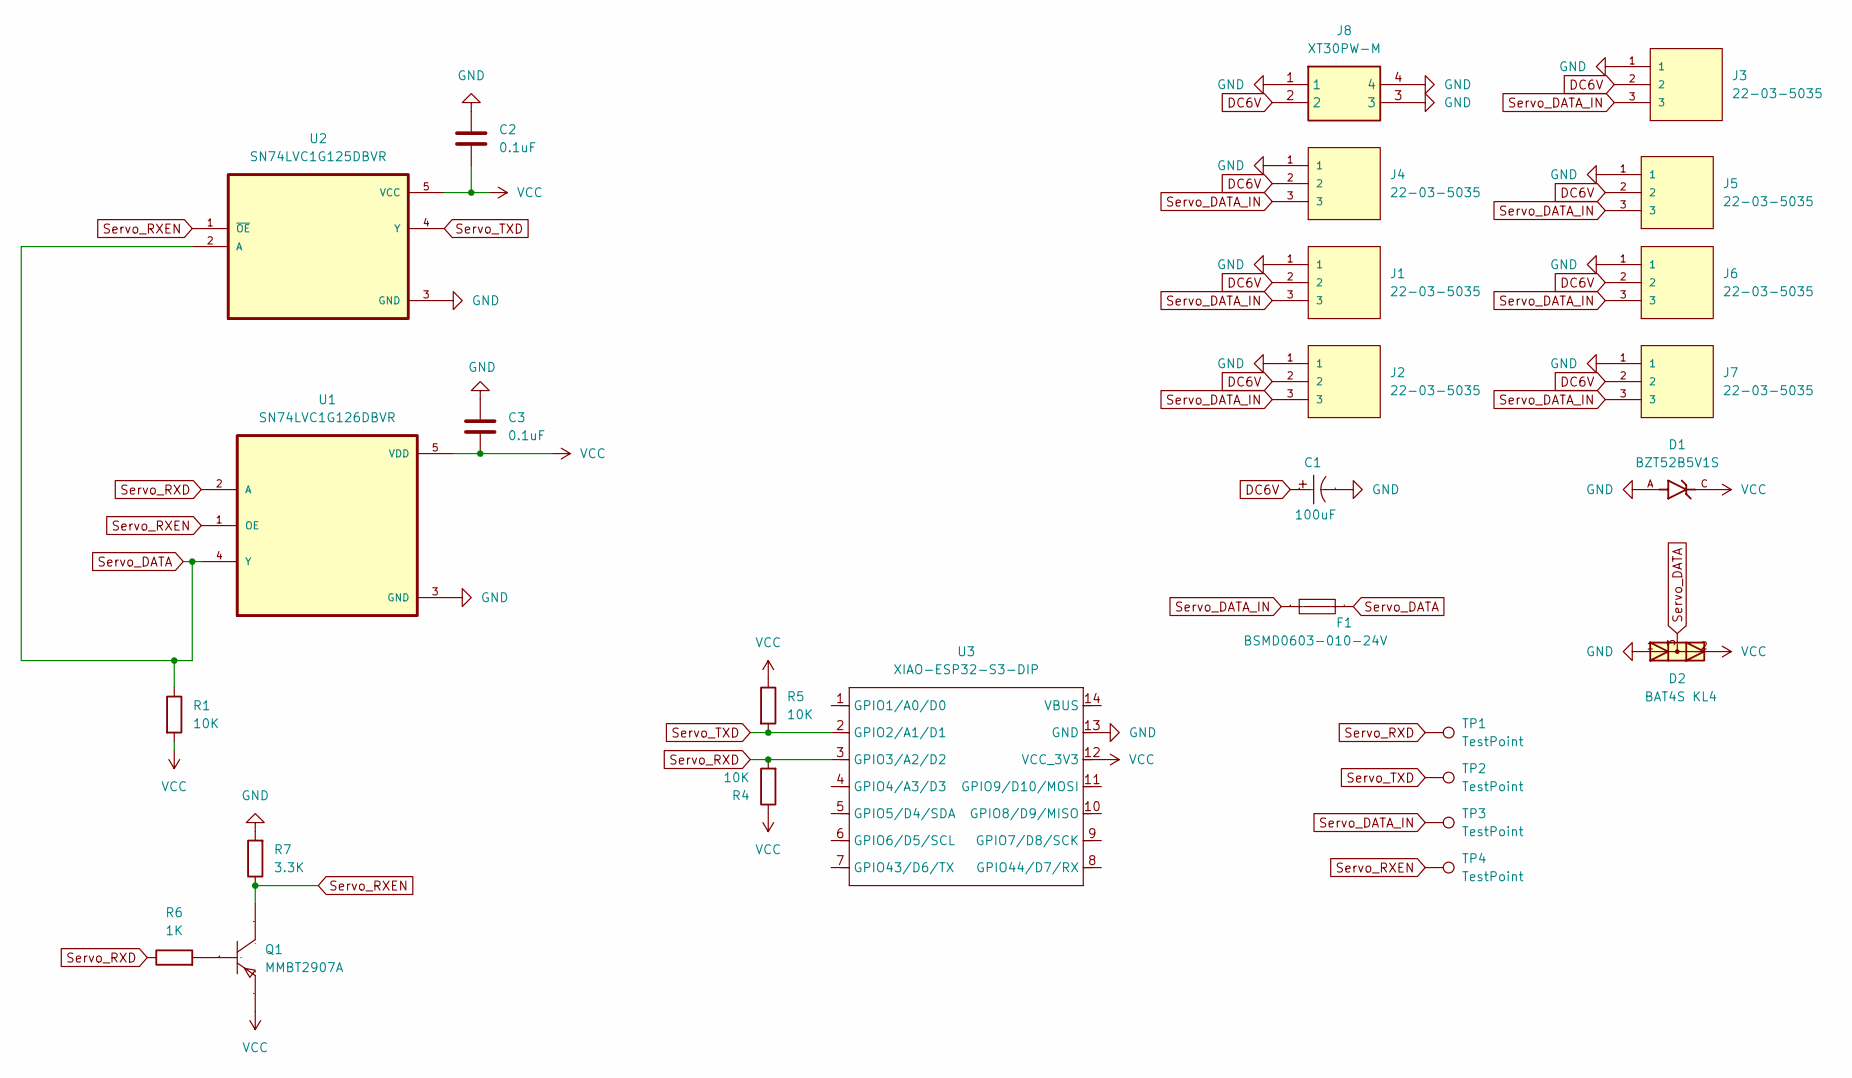
[picture p156: schematic Aero-Hand-Open-Left.kicad_sch, OpenSourceHand_PCB]

Parts:
C1: 100uF; CAP-TH_BD5.0-P2.00-D0.8-FD; Manufacturer Part KM107M025D11RR0VH2FP0; LCSC Part Name 100uF ±20% 25V
C2, C3: 0.1uF; C_0805
D1: BZT52B5V1S; DIO_BZT52B5V1S; PARTREV H2212
D2: BAT54S; BAT4S KL4
F1: BSMD0603-010-24V; F0603; Manufacturer Part BSMD0603-010-24V; LCSC Part Name 24V 100mA 0603自恢复
J1, J2, J3, J4, J5, J6, J7: 22-03-5035; MOLEX_22-03-5035; PARTREV B
J8: XT30PW-M; XT30PWM; Manufacturer_Part_Number XT30PW-M
Q1: MMBT2907A; transistor-SOT-23-3_L3.0-W1.7-P0.95-LS2.9-BR; Manufacturer Part MMBT2907A; LCSC Part Name MMBT2907A
R1, R4, R5: 10K; R_0805
R6: 1K; R_0805
R7: 3.3K; R_0805
TP1, TP2, TP3, TP4: TestPoint; TestPoint_Pad_D1.0mm
U1: SN74LVC1G126DBVR; DigiKey_Part_Number 296-11605-1-ND
U2: SN74LVC1G125DBVR
U3: XIAO-ESP32-S3-DIP; XIAO-ESP32S3-SMD

Connections:
DC6V: C1.1, J1.2, J2.2, J3.2, J4.2, J5.2, J6.2, J7.2, J8.2
GND: C1.2, C2.1, C3.1, D1.A, D2.1, J1.1, J2.1, J3.1, J4.1, J5.1, J6.1, J7.1, J8.1, J8.3, J8.4, R7.2, U1.3 (GND), U2.3 (GND), U3.13 (GND)
unnamed: Q1.1 (B), R6.2
Servo_DATA: D2.3, F1.2, R1.1, U1.4 (Y), U2.2 (A)
Servo_DATA_IN: F1.1, J1.3, J2.3, J3.3, J4.3, J5.3, J6.3, J7.3, TP3.1
Servo_RXD: R4.2, R6.1, TP1.1, U1.2 (A), U3.3 (GPIO3/A2/D2)
Servo_RXEN: Q1.3 (C), R7.1, TP4.1, U1.1 (OE), U2.1 (~OE)
Servo_TXD: R5.2, TP2.1, U2.4 (Y), U3.2 (GPIO2/A1/D1)
VCC: C2.2, C3.2, D1.C, D2.2, Q1.2 (E), R1.2, R4.1, R5.1, U1.5 (VDD), U2.5 (VCC), U3.12 (VCC_3V3)

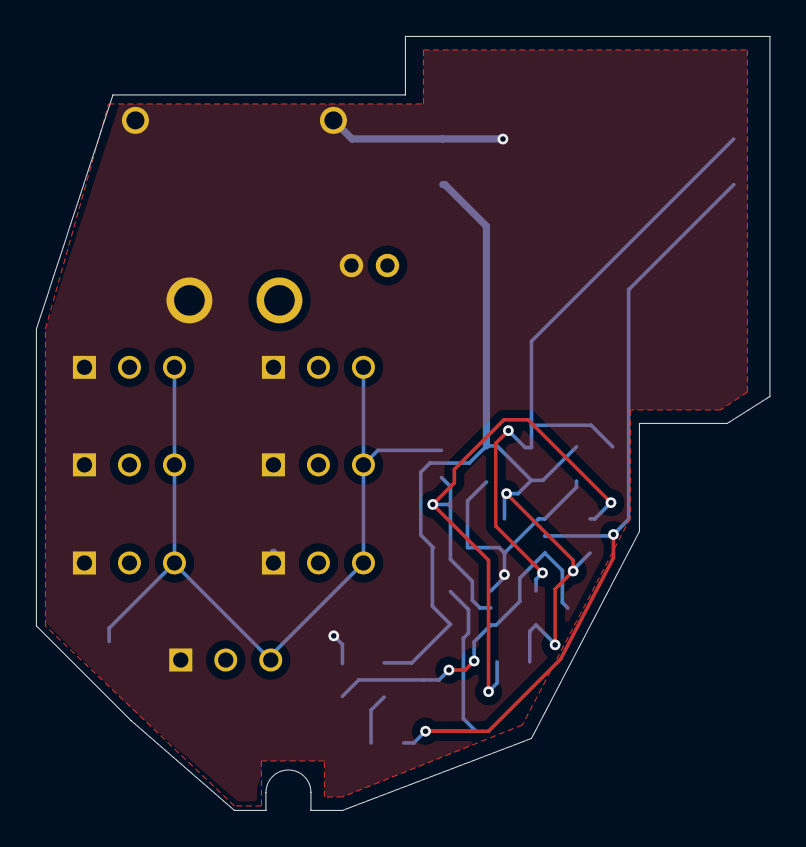
[picture p157: board Aero-Hand-Open-Left.kicad_pcb from above]

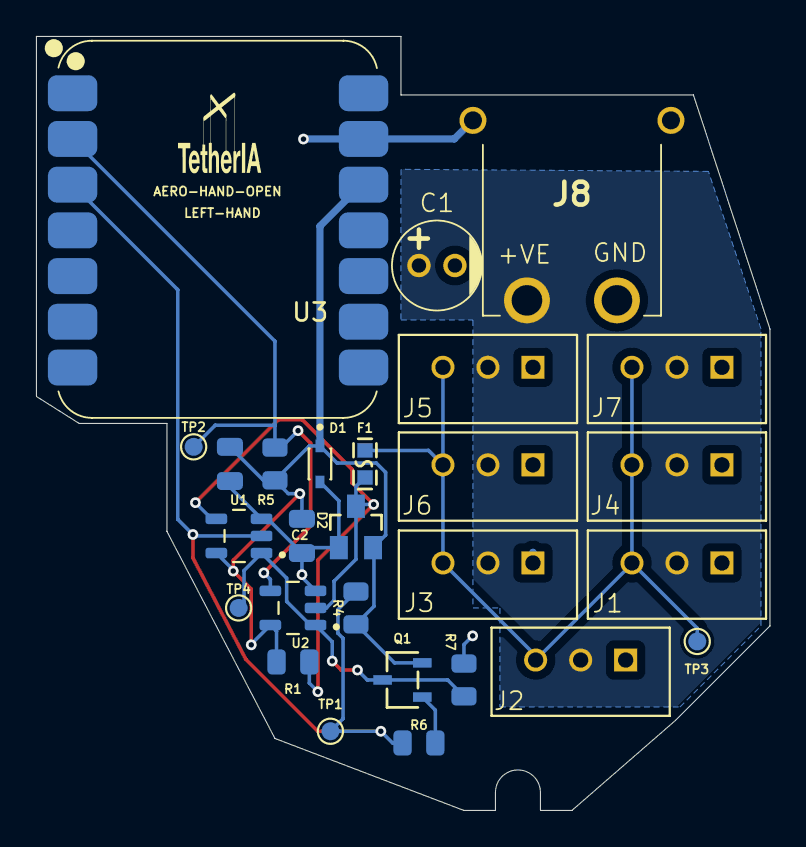
[picture p158: board Aero-Hand-Open-Left.kicad_pcb from below]

Board: 2 copper layers, 40.7 x 43.0 mm, 27 parts (26 on the bottom side), 9 nets.
