ss1-ops/robotic-arm-5-digit-manipulator/software/pi/moveo_ws/src/moveo_moveit_config/config/joint_limits.yaml

# Joint velocity/acceleration limits for MoveIt planning
joint_limits:
  Joint_1:
    has_velocity_limits: true
    max_velocity: 1.0
    has_acceleration_limits: true
    max_acceleration: 2.0
  Joint_2:
    has_velocity_limits: true
    max_velocity: 1.0
    has_acceleration_limits: true
    max_acceleration: 2.0
  Joint_3:
    has_velocity_limits: true
    max_velocity: 1.0
    has_acceleration_limits: true
    max_acceleration: 2.0
  Joint_4:
    has_velocity_limits: true
    max_velocity: 1.0
    has_acceleration_limits: true
    max_acceleration: 2.0
  Joint_5:
    has_velocity_limits: true
    max_velocity: 1.0
    has_acceleration_limits: true
    max_acceleration: 2.0
