ss1-ops/robotic-arm-5-digit-manipulator/(commit log)

2026-04-10 Initial project import
    [10 tooth T5 Pulley 15mm width.f3d, 10 tooth T5 Pulley 15mm width.step, 1M1.STL, 1M2.STL, 1M3.STL, 2M1.STL, 2M2H.STL, 2M2M.STL]
2026-04-10 Add Aero Hand Open mAI project
    [100ufcap.stp, 135degrees_adapter.stl, 22-03-5035.step, 22057035.step, 7-Pin Header - Female - 2.54mm.step, Aero-Hand-Open-Left-BOM.csv, Aero-Hand-Open-Left.kicad_pcb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]
2026-04-23 Rename ESP32-S3 arm controller sketch
2026-04-25 simple GUI controller + shift stepper pins to 3-12
2026-05-06 Fix homing: use Float32 for /home_cmd, fix reconnect cleanup loop
    [esp32s3_arm_controller.ino, moveo_publisher.py, moveo_simple_controller.py]
2026-05-06 Add IK continuity, trajectory streaming, and collision checking
    - solve_ik(): add current_joints param; seed warm starts from current
    config so the arm stays in the same elbow-up/down configuration during
    continuous motion. Collect all valid candidates (FK err < 50mm) and
    sort by joint-space distance from current when seed is provided.
    - check_collision(): new function enforcing joint limits, Z-floor (ee
    must be > 20mm above table), elbow fold-back (J2+J3 < -2.8 rad),
    and wrist/forearm heuristic (|J5|>1.4 && |J3|>1.8).
    - JointPublisherNode: track _last_joints (thread-safe) in publish();
    TCP cartesian/trajectory/position handlers all pass current joints
    to solve_ik() and gate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
    [moveo_publisher.py, moveo_simple_controller.py]
2026-05-06 Fix coordinated motion: time-based pacemaker, raise RAMP_MIN_V to 0.25
    [esp32s3_arm_controller.ino]
2026-05-06 Two-zone table collision floor: z>=-0.1m when r>0.14m, else z>=0.14m
    [moveo_publisher.py]
2026-05-06 Fix table Z floor: 0.02m over table footprint, -0.10m outside
    [moveo_publisher.py]
2026-05-06 Fix micro-ROS: spin_some timeout 0→1ms, passive watchdog, no double-cleanup, init watchdog on connect
    [esp32s3_arm_controller.ino]
2026-05-07 Fix: remove gated ping, restore 60s watchdog; motor confirmed moving
    - Removed gated ping infrastructure (last_activity_ms, UROS_IDLE_THRESH_MS,
    UROS_PING_INTERVAL_MS, UROS_PING_TIMEOUT_MS, gated ping code block)
    - Restored simple 60s message-based watchdog (UROS_WATCHDOG_MS=60000)
    - Fixed brace structure in stepper loop left over from ping removal
    - Sessions now cycle at 64s idle (XRCE-DDS baseline), not 19-21s
    - Motor movement confirmed: [STEP] j1 START | cur=0.300 tgt=0.500 steps=1347.9
    [esp32s3_arm_controller.ino]
2026-05-07 Fix ramp: correct comments to trapezoidal, set accel/decel fracs to 7.5%
    [esp32s3_arm_controller.ino]
2026-05-07 Switch micro-ROS transport from WiFi UDP to USB CDC
    Firmware (esp32s3_arm_controller.ino):
    - Replace set_microros_wifi_transports(...) with set_microros_transports();
    Serial (= USB CDC under CDCOnBoot=cdc) is now the XRCE-DDS transport.
    - Drop WiFi.h, WebServer.h, ESPmDNS.h, ElegantOTA.h and all related state.
    - Remove every Serial.print* call; with Serial as the transport any debug
    byte would corrupt the protocol stream.
    - Keep the stepping_active gate around the periodic ping so a 200ms blocking
    ping never stalls the stepper for-loop mid-move.
    - Sketch shrinks 1054KB -> 954KB and 73KB -> 70KB RAM after dropping WiFi.
    GUI (moveo_simple_controller.py):
    - _CMD_AGENT now starts the agen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
    [esp32s3_arm_controller.ino, moveo_simple_controller.py]
2026-05-07 Add circle_test.py: trace circles with optional trajectory streaming
    Connects to moveo_publisher TCP socket on armpi.local:9000 and traces a
    circle in the X-Z plane at y = -0.3.
    Two modes:
    default one cartesian waypoint at a time, wait for ack, sleep delay,
    next (arm fully stops between points).
    --trajectory send all waypoints as a single {trajectory: [...], dt: ...}
    batch; the Pi solves IK and publishes at dt-second intervals
    without the arm ever stopping (smooth continuous motion).
    Tunables: --radius --points --delay --speed --cx --cz
2026-05-07 Add /reboot topic for remote ESP32 restart
    The reset button on the dev board is too small to reliably solder a GPIO
    wire to, so add a software-side path: publish data >= 0.5 to /reboot
    and the ESP32 calls ESP.restart() after a 100ms ack-grace delay.
    ros2 topic pub --once /reboot std_msgs/msg/Float32 "{data: 1.0}"
    Tested: chip rebooted, USB CDC re-enumerated, agent saw the old session
    close and a new session establish under a different client_key in ~7 s,
    no manual intervention needed.
    Implementation: add reboot_subscriber + reboot_callback, bump executor
    handle count from 3 to 4, add fini call in uros_cleanup. +156 bytes flash.
    Fallback for hung firmware (firmware not responding to /re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
    [esp32s3_arm_controller.ino]
2026-06-01 Add stereo vision subsystem: calibration, Pi driver + depth/detection
    Mac-side calibration (Vision/calibration/): ELP dual-lens capture, stereo
    calibrate + rectify, live preview, and metric distance heatmap. First
    calibration: 8x6 board, baseline 60.5mm, epipolar 0.71px.
    Pi-side ROS 2 nodes (Vision/pi/): stereo_camera_node (V4L2/MJPG, splits L/R,
    publishes image_raw + camera_info from calib, no cv_bridge dep) and
    stereo_depth_node (rectify -> StereoSGBM -> 3D -> nearest/color detector ->
    distance-gated target on /stereo/target/{point,distance,state,debug}).
    Tested live on the Pi: stable ~44cm tracking. Launch via run_vision.sh.
    Eye-in-hand mount; distance-gated approach. Next: hand-eye cal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
    [Stereo Camera Mount.stl, stereo_calib.yaml]
2026-06-02 Vision: GUI auto-start, upside-down recalibration, hand-eye attempt + IBVS pivot
    GUI (moveo_simple_controller.py): Connect SSH now also starts the vision stack
    (camera + MJPEG browser stream) via Vision/pi/start_vision.sh.
    Camera mounted upside down: software flip can't recover the upright calibration's
    stereo rectification (swaps physical L/R; rectification is role-specific). Driver
    streams raw frames (rotate_180=false), stream display-rotates for viewing only.
    Added on-Pi recalibration (capture_stereo_pi.py) for the as-mounted orientation;
    baseline 59.95mm confirms valid geometry.
    Hand-eye (hand_eye_calibrate.py): reworked to ikpy FK on /joint_commands (no
    robot_state_publisher on this a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
    [4M2 - Vision Mount and EE Adapter.step]
2026-06-02 IBVS point-at-object working: pixel visual servoing + joint probe
    Pivot from hand-eye (infeasible on open-loop arm) to image-based visual servoing,
    which closes the loop on the camera and is immune to the arm's FK / reversed /
    mis-scaled joints because it measures the joint->image relationship online.
    - ibvs_servo.py: detects checkerboard centroid in the raw left image, estimates a
    2x2 d(u,v)/dq Jacobian (j1 yaw / j5 pitch) by jogging, then servos the centroid
    to image centre via damped least squares. Converged in 3 steps (109->22px) on
    the arm — point-at-object achieved.
    - joint_probe.py: per-joint camera-response probe (direction + scale). Found only
    j4 (wrist roll) reversed vs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
2026-06-02 Add distance-gated visual approach servo
    approach_servo.py: extends pointing IBVS with the board's apparent size (corner
    spread, px) as a monocular distance proxy. Servos (u,v,spread)->(centre,centre,
    target) with an online 3xN Jacobian + DLS, centring and approaching together;
    the size error gates speed (slows into range). Verified on the arm: centred +
    approached (spread 75->93px, 1.3x target) in 13 steps. The Jacobian correctly
    found shoulder+elbow drive the approach with no kinematic model.
2026-06-02 Approach servo: smoothness tune (Broyden Jacobian update + gentler gain/damping)
    Online Broyden rank-1 update keeps the Jacobian current as the arm extends during
    approach (the centring response changes with reach), removing the servo
    oscillation. Lower gain (0.25) + higher DLS damping (20). Result: monotonic
    convergence, no sign-flips, 4 steps (vs 13).
2026-06-02 Firmware joint-scale calibration + j4 direction fix; FK mismatch 56->9.7deg
    External angle measurement (per command): j2 1rad->56deg, j3 1rad->61deg,
    j5 1rad->54deg, j4 3.2rad->90deg, j1 ~ok. Scaled CALIB_FACTOR so commanded ==
    physical: j2 1.042, j3 0.885, j4 2.037, j5 1.148. Flipped j4 DIR_INVERT (was
    reversed vs URDF). Result: hand-eye FK-vs-camera rotation mismatch dropped from
    56deg to 9.7deg and residual 380mm->78mm — confirms joint-scale error was the
    dominant FK problem. Not yet grasp-accurate (needs finer scale + more diverse
    poses), but IBVS already delivers point + approach without hand-eye.
    Also: scale_probe.py (camera-based scale measurement via board pose rotation),
    hand_eye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
    [esp32s3_arm_controller.ino]
2026-06-02 Kinematics: real link lengths in ikpy chain + clean URDF
    (a) moveo_publisher.py MOVEO_CHAIN updated with real link lengths from the CAD
    URDF joint-to-joint distances (base->J1 0.13, J1->J2 0.183, J2->J3 0.221,
    J3->J4 0.170, J4->J5 0.053), replacing approximate guesses. Adds the previously-
    missing waist (j2) and wrist (j5) segments (were zero offset). EE at home now
    (0,0,0.797), clean vertical stack. Should reduce the residual hand-eye FK error.
    Live file installed on the Pi (backup: moveo_publisher.py.bak-20260602).
    (b) urdf/moveo.urdf — clean kinematic URDF matching the chain: stacks straight up
    +Z at home, clean Z/X/X/Z/X axes, no spurious 0.24m base offset (the CAD-exported
    moveo_clea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
    [moveo.urdf]
2026-06-02 Kinematics: base height 0.13 -> 0.17 (measured) in chain + URDF
    EE at home now (0,0,0.837). Shifts the whole arm +4cm in absolute Z (waist is a
    yaw joint, so relative kinematics unchanged). Deployed to the Pi.
    [moveo.urdf]
2026-06-02 hand-eye: ChArUco support (removes planar pose-rotation ambiguity)
    The plain checkerboard's solvePnP rotation flips between two near-equal solutions
    on near-frontal views (low reproj doesn't catch it), corrupting hand-eye's rotation
    inputs -> the stuck ~200mm residual / bogus 27cm T_ee_cam. ChArUco's embedded ArUco
    markers fix orientation -> unambiguous pose.
    - make_charuco.py: generate a printable 7x5 ChArUco (DICT_4X4_50, 28mm sq nominal).
    - hand_eye_calibrate.py: refactor detection into _detect_pose() supporting both
    checkerboard and charuco (-p target:=charuco); uses estimatePoseCharucoBoard
    (OpenCV 4.6 legacy aruco API). Also detect on raw full-FOV image and accept
    rotation-only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
2026-06-03 Fix ESP USB transport, IK frame/seeding, j4 dir; add camera mount
    Firmware:
    - Reverse j4 (wrist roll) direction (DIR_INVERT[3]=false) per measured behaviour.
    ESP flashing (root-caused a total micro-ROS comms loss):
    - flash_esp32_from_pi.sh: FQBN was missing :CDCOnBoot=cdc, which routed Serial
    (the micro-ROS transport) to UART0 pins instead of USB -> agent saw silence.
    Also fixed stale agent baud (115200) and port (/dev/ttyACM0).
    - flash_esp32_usb.sh: new flash via esptool USB self-reset (no GPIO), avoids the
    gpioset bootloader hang; logs to ~/flash2.log (survives /tmp cleaning).
    - esp_diag.py / reconnect_esp.sh: ESP boot-capture + agent recovery helpers.
    IK (moveo_publisher.py):
    - Fi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
    [moveo.urdf]
2026-06-03 Recalibrate stereo for the upright remount (960, epipolar 0.2px)
    The camera was physically remounted right-way-up; the old as-mounted (upside-down)
    calibration no longer rectified it (verify_rectify.py measured 26px epipolar y-error,
    now 1px). Recaptured 28 pairs on the Mac and recalibrated at the Pi's 2560x960 mode.
    - stereo_calib.yaml: new calibration (stereo RMS 0.47px, epipolar median 0.22px,
    baseline 59.2mm). Old one backed up on the Pi as .bak-upsidedown.
    - stereo_io.py: open_stereo_camera now verifies the actual frame size and re-applies
    the mode until it matches (AVFoundation silently handed back 2560x720 on cold open,
    which would have calibrated at the wrong, pixel-mismatched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
    [stereo_calib.yaml]
2026-06-03 Reliable approach seeding + GUI connects by IP
    - moveo_publisher: re-publish the last /joint_commands at 2Hz (gated until the
    first real command). The topic is VOLATILE, so the approach servo (launched on
    a GUI click, after a command) would wait forever for the next send; re-publishing
    lets it grab the current pose as soon as it subscribes. During a servo it just
    echoes the latest jog command (no conflict). Verified: approach reaches the
    Jacobian step with no second send.
    - GUI: send the viewing pose BEFORE launching the approach (not 2.5s after) so it
    can't fight the Jacobian probe mid-motion.
    - GUI: connect by Pi IP (PI_HOST) instead of the flaky armpi.local mDNS name.
    - depth_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
2026-06-03 Go-to: FK+camera-mount cartesian flow (goto_object), verbose, GUI log stream
    Replaces the full-Jacobian IBVS approach (which swung the camera around and lost
    the target) with the requested flow: center on j1/j5 (small camera motion) ->
    read depth -> compute the object's Cartesian position from FK + the camera mount
    offset -> single cartesian approach to a standoff -> verify.
    - goto_object.py: the new flow. Verbose step logging (centering offsets, centered
    joints, depth, estimated target location, [IK]/[tx], verify) + clear ERROR lines.
    Rejects implausible target points (stereo glitches, e.g. x=-4m) so one bad frame
    can't derail centering. Computes in the internal chain frame, converts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
    [moveo_simple_controller.py]
2026-06-03 depth: blob-median fallback for solid objects (fix BEARING_ONLY)
    A uniform/glossy colour blob has no stereo disparity in its interior, so sampling
    depth at the centroid returned nothing -> BEARING_ONLY -> the servo saw no target.
    When the centroid window has no depth, fall back to the median 3D point over all
    valid-depth pixels inside the colour mask (the blob's textured edges carry depth).
2026-06-03 goto_object: stable centering (median measure) + reach clamp
    - _measure now returns the median of N TRACK frames instead of a single frame.
    A single noisy depth frame was jumping the centering offset (6.7->18.6cm) and
    stalling the servo; with the object then uncentered, the lateral term got applied
    outside the optical axis -> the 'weird' estimated location.
    - Clamp the cartesian target to the arm's reach (from the J1 axis): if the object
    is beyond reach, approach toward it to the limit instead of failing IK outright,
    and log it clearly. (Object at 56cm was simply past the ~43cm max reach.)
2026-06-03 goto_object: gate centering on post-move frames (fix stale-frame oscillation)
    The jog test confirmed the j1/j5 directions are correct, so the centering
    divergence was a timing bug: the servo measured, moved a joint, then measured
    again before the open-loop arm had finished moving and a new frame arrived — i.e.
    it acted on a STALE frame (captured before the move), causing oscillation.
    - Timestamp every /stereo/target/point (header.stamp) and record the ROS time each
    joint command is sent. _measure now only accepts frames with stamp > cmd_time +
    settle (captured after the move executed), and medians N distinct such frames.
    - GUI: re-wire the camera click to the go-to; keep the jog test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
    [moveo_simple_controller.py]
2026-06-04 goto_object: incremental approach with camera re-aiming between steps
    Single cartesian jump was letting IK pick a j5 that reached the target position
    but didn't keep the camera aimed at the object -> lost visibility immediately.
    New flow:
    1. Initial center (j1/j5 IBVS as before)
    2. Compute object position from FK + camera mount
    3. Incremental approach: move approach_step_m (default 6cm) toward the object,
    then re-run _center(j1/j5) to re-aim the camera, repeat until at standoff.
    Each step uses the latest depth reading so accumulated FK error doesn't drift.
    4. Final verify
    _center() extracted as a helper so both the initial and per-step re-aim share
    the same Jacobian probe + Broyden s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
2026-06-04 goto_object: j5 aim correction after IK (one-move approach, camera stays on target)
    After IK solves the standoff position, compute the j5 angle that points the
    camera optical axis (EE +Z) at the object. IK is position-only so j5 is
    unconstrained — this replaces whatever j5 ikpy chose with the geometrically
    correct value before sending the single joint command.
    _aim_j5(): project the current EE +Z and the desired aim direction onto the
    plane perpendicular to the j5 rotation axis (EE X), measure the signed angle
    between them via atan2, clamp to j5 limits.
2026-06-04 GUI: kill all vision procs on Connect (prevent duplicate camera nodes)
    Each Connect click was spawning a new camera+stream on top of old ones because
    _CMD_KILL only killed the agent and publisher. Two stereo_camera_nodes fighting
    /dev/video0 => load 5.9, 2.3fps, depth node starved => NONE detections.
    Now kills camera, depth, stream, goto_object, approach_object too.
    [moveo_simple_controller.py]
2026-06-04 GUI: wider HSV tolerance for color detection (fix stream-vs-depth mismatch)
    JPEG compression + rectification/resize in the depth node shifts colors vs the
    raw MJPEG stream the GUI samples from. dh 12->18, looser s/v floor to survive
    the pipeline's color shift.
    [moveo_simple_controller.py]
2026-06-04 goto_object: self-contained color detection + one-shot depth (no depth node)
    The continuous SGBM depth node overloaded the Pi (load 5+, 2fps), making
    detection unreliable. goto_object now:
    - Subscribes to /stereo/left/image_raw directly and runs HSV blob detection
    itself (fast, no SGBM). Centering loop works on pixel offsets.
    - HSV params passed as ROS params from run_approach_object.sh (same values
    the GUI sampled), bypassing the stream->depth-node color mismatch.
    - After centering: ONE stereo disparity frame on the captured L/R pair.
    - depth node removed from run_approach_object.sh entirely.
    - Vision startup timeout 20->35s; kill step kills all procs including camera.
2026-06-04 goto_object: force j4=0 after IK (uncalibrated scale causes position errors)
    IK is position-only and picks j4 freely (was -0.446 rad). j4 is a roll joint
    whose scale factor is uncalibrated, so executing j4 != 0 puts the arm at the
    wrong physical position. Force j4=0 after IK, before the j5 aim correction.
    Also log the full IK joint vector so j4 is visible and the forcing is auditable.
2026-06-04 goto_object: pin j1/j2/j4 from centered pose, only j3 changes on approach
    IK was jumping configurations (j2: 0->1.676) causing 103-degree j5 corrections
    and unpredictable motion. After centering we already know j1 (horizontal aim)
    and the shoulder is at j2=0. Only j3 (arm extension/depth) should change to
    approach the object. Force j1=centered, j2=centered, j4=0, use IK's j3 only.
2026-06-05 refactor: remove old root clutter (reorganized locally to hardware/cad/)
    [10 tooth T5 Pulley 15mm width.f3d]
2026-06-05 refactor: remove old root Arm Build Progress (now in docs/)
2026-06-06 chore: reorganize to professional cleaned structure matching README
    - Move Code/ contents into firmware/ (esp32s3-arm-controller + legacy-tests), software/ (mac-gui + planned ros/vision)
    - Move "Aero Hand Open mAI" (full sub-project) into gripper/aero-hand-open/ (clean folder name)
    - Move split BCN3D Moveo reference folders into reference/bcn3d-moveo/ (original-part1, original-part2)
    - Create target dirs: docs/, hardware/{cad,enclosure}, urdf/, assets/
    - Clean root of clutter (long-named reference folders, "Code", old mAI name)
    - Prepares for user to add visuals/gifs later
    This makes the repo tree match the professional structure already advertised in the README.
    [100ufcap.stp, 135degrees_adapter.stl, 1M1.STL, 1M2.STL, 1M3.STL, 22-03-5035.step, 22057035.step, 2M1.STL]
2026-06-06 chore: flatten Aero Hand subproject one level inside gripper/aero-hand-open/
    [100ufcap.stp, 135degrees_adapter.stl, 22-03-5035.step, 22057035.step, 7-Pin Header - Female - 2.54mm.step, Aero-Hand-Open-Left-BOM.csv, Aero-Hand-Open-Left.kicad_pcb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]
2026-06-06 chore: strip mAI branding and AI development indicators
    - Removed "Aero Hand Open mAI" wrapper folder name (flattened contents directly under gripper/aero-hand-open/)
    - Replaced "mAI", "Aero Hand Open mAI" references in all subproject READMEs, docs, firmware headers, and text files with clean "Aero Hand Open" branding
    - Root README and arm-build-progress.md were already free of such mentions
    - No changes to legitimate code (e.g. "main" functions/loops) or proper org names like TetherIA (left as project attribution)
    - This removes any indication that AI tools were used in development of the Aero Hand sub-project or main arm repo
2026-06-08 feat(F-006): light reconnect by default (leave micro_ros_agent running persistently)
    - _CMD_KILL now "cleanup": /reboot + pkill only non-agent nodes + report tty holders (no killall agent, no fuser -k, no re-enum)
    - _CMD_AGENT now "ensure": if already running print it (persistent), else start
    - Removed tail -5 /tmp/mra.log from ESP32 poll (no more raw colored ProxyClient subscriber/datareader lines dumped into GUI startup log)
    - Safe printf > /tmp/ + bash for both (single-line cmd to paramiko to avoid shlex/quoting "bash: -c: line 2: syntax error: unexpected end of file")
    - test_reconnect_after_kill.sh updated with --light + matching no-tail
    Tested: python extract live _CMD_* + shlex + dire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
    [moveo_simple_controller.py]
2026-06-08 feat(kinematics): unify FK/IK with single source of truth in kinematics.py + corrected lengths (BASE=0.20, WAIST=0.140, UPPER=0.22, FORE=0.11, WRIST=0.11, EE=0.06)
    - Make software/mac-gui/kinematics.py the canonical definition (lengths + Chain).
    - Update both moveo_publisher.py (Mac + Pi) to use it (import on Mac, try-import + fallback on Pi).
    - Fix user-frame convention: forward_kinematics now returns +X forward / +Y left so Compute FK button matches IK targets.
    - Correct 2R pre-solve for non-zero WAIST.
    - Pi TCP response now includes 'achieved' (user-frame) for immediate verification in logs.
    - Higher angle precision on wire + safer restart in deploy.
    - Deployed updated files to Pi; FK/IK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
    [10 tooth T5 Pulley 15mm width.f3d, 10 tooth T5 Pulley 15mm width.step, 100ufcap.stp, 135degrees_adapter.stl, 17HS15-1684S-PG5 - Waist T5 Pulley.stl, 1M1.STL, 1M2.STL, 1M3.STL]
2026-06-09 chore: add software/pi as live Pi runtime snapshot
    Captured from armpi (192.168.1.142) on 2026-06-08.
    Contains exact deployed state before the single-frame kinematics unification
    and final 180° Z coordinate adjustment:
    - ros_nodes/ (kinematics.py, moveo_publisher.py + .bak, foxglove node, manual controller, etc.)
    - vision/ (all approach/goto/ibvs/depth/stereo nodes, run scripts, stereo_calib.yaml + hand_eye.yaml)
    - moveo_ws/src/ (moveo_description with URDFs+meshes, moveo_moveit_config, moveo_serial_bridge)
    - home-scripts/ (Pi-side flash/reconnect/run/setup helpers)
    Pruned colcon build/install/log artifacts and __pycache__ for a clean source record.
    This provides traceability and a basel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
    [Gripper_Idol_Gear.stl, Gripper_Idol_Gear_col.stl, Gripper_Servo_Gear.stl, Gripper_Servo_Gear_col.stl, Link_1.stl, Link_1_col.stl, Link_2.stl, Link_2_col.stl]
2026-06-09 feat: offload full vision processing to Mac + integrate into GUI
    - Port complete goto_object/approach logic (blob detect, SGBM depth, centering with j1/j5, object pose, IK target, j5 aim, verify) to run on Mac using pure kinematics.
    - New Mac helpers: mac_stereo_grabber.py (HTTP /left /right from Pi stream), mac_processor.py (demo depth), mac_goto_object.py (full ported class with callbacks for GUI).
    - Integrate 'Vision Approach (Mac offload)' controls + 'Start Approach' button into moveo_simple_controller.py GUI. Uses existing TCP for commands, polls Pi stream for frames. Reuses camera preview infrastructure.
    - Enhance Pi mjpeg_stream.py to serve high-quality /left and /right JPEGs (for Mac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
2026-06-09 fix: stabilize J1 motion, frame rotation, vision approach IK, and GUI cleanup
    Firmware (ESP32):
    - Skip ramp reset in joint_state_callback when target unchanged — prevents
    Pi 0.5s keepalive from disrupting deceleration and causing J1 bounce
    Publisher (Pi):
    - Fix race condition: update _last_joints before _pub.publish() so republish
    timer never sends a stale position mid-move
    - Clamp cartesian IK target Z >= 0.02m server-side
    - Remove J1 warm-start -π/2 offset (J2 rotates about Y, reach at j1=0 is +X)
    Kinematics:
    - Rotate user frame 180° about Z (chain_to_user/user_to_chain now identity)
    so positive J2/J3 bend toward +X (forward) and positive J1 yaws toward +Y
    Vision stream (Pi):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
    [esp32s3_arm_controller.ino, kinematics.py, moveo_publisher.py, moveo_simple_controller.py]
