ss1-ops/robotic-arm-5-digit-manipulator/(notices)

Notices in the files:
gripper/aero-hand-open/ros2/README.md:
License: Apache 2.0
